asamland/NU-Smarticle/XBee3_Micro_Info/Image 2.jpeg

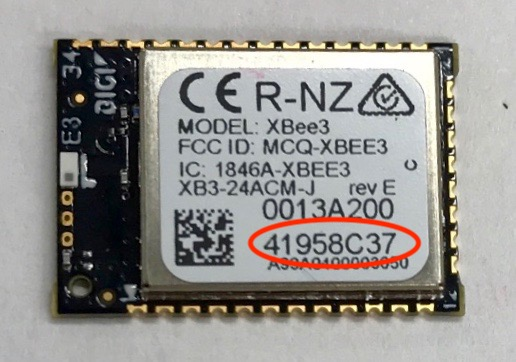
XBee3_Micro_Info/Image 2.jpeg
