asamland/NU-Smarticle/NU-Smarticle PCB Design/BOMs/Assemblyv2_BOM.xlsx

Item | Qty | Manufacturer | Mfg. Part No | Description
1 | 2 | Turnigy | 1440-A Servo (https://hobbyking.com/en_us/turnigytm-tgy-1440a-analog-servo-v2-0-8kg-0-10sec-4-4g.html) | Servos
2 | 1 | Molex | 51281-1294 (https://www.mouser.com/ProductDetail/Molex/51281-1294) | Connector b/w feather and top board
3 | 1 | eBoot | 1.25 mm JST 2 Pin Micro Female Connector (https://www.amazon.com/eBoot-Pairs-Electrical-Female-Connector/dp/B06WGM9W7S) | Battery connector
4 | 1 | Turnigy | nano-tech 200mAh 1S 35 (https://hobbyking.com/en_us/turnigy-nano-tech-200mah-1s-35-70c-lipoly-battery-5pcs.html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) | Battery
