asamland/NU-Smarticle/NU-Smarticle PCB Design/BOMs/Feather_BOM.xlsx

Item# | Ref Des | Qty | Manufacturer | Mfg Part no. | Package | Description/ Value | Type
1 | C8, C9, C11 | 3 |  |  | 0603 | 10nF | SMD
2 | C4, C6, C7, C10, C13 | 5 |  |  | 0603 | 0.1 uF | SMD
3 | C1,C14 | 2 |  |  | 0603 | 1.0uF | SMD
4 | C2,C3,C5,C12,C15 | 5 |  |  | 0603 | 10uF | SMD
5 | CON1 | 1 | Amphenol ICC | 10103594-0001LF |  | Micro B USB Connectors | SMD
6 | CON100 | 1 | Molex | 512811294 |  |  | SMD
7 | D1 | 1 |  |  | CHIP-LED 0603 | Red LED | SMD
8 | D2 | 1 | Diodes Inc. | SDM100K30L-7 | SOD-323 | Schottky Diode | SMD
9 | D3 | 1 |  |  | CHIP-LED 0603 | Orange LED | SMD
10 | Q1 | 1 | Didoes Inc. | DMG3418L | SOT23-R | P-Channel Mosfet | SMD
11 | R1, R2, R4, R6 | 4 |  |  | 0603 | 1K | SMD
12 | R3, R5, R10 | 3 |  |  | 0603 | 10k | SMD
13 | R7, R8, R9 | 3 |  |  | 0603 | 100k | SMD
14 | S1 | 1 | C&K | KMR231NG LFS |  | SMT Tact Switches | SMD
15 | S2 | 1 | C&K | PCM12SMTR |  | Single Pole, Double Throw (SPDT) Switch | SMD
16 | U1 | 1 | Microchip Technology | MCP73831T-2DCI/OT | SOT23-5 | MCP73831/2 LIPO Charger | SMD
17 | U2 | 1 | Diodes Inc. | AP2112K-3.3 | SOT23-5 | SOT23-5 Fixed Voltage Regulators | SMD
18 | U3 | 1 | Silicon Labs | CP2104 | QFN24_4MM_SMSC | CP2104 - USB to UART Bridge | SMD
19 | U4 | 1 | Microchip Technology | ATmega328PB-MUR | 32VFQFN | IC MCU 8BIT 32KB FLASH 32VFQFN | SMD
20 | U5 | 1 | Analog Devices | ADXL337BCPZ-RL | LFCSP_LQ-16 | ADXL337 Low Power 3-Axis ¬±3 g Accelerometer with Analog Output. | SMD
21 | Y1 | 1 | Murata | CSTNE8M00GH5C000R0 |  | 8mhz resonator | SMD
