asamland/NU-Smarticle/NU-Smarticle PCB Design/BOMs/TopBoardv2_BOM.xlsx

Item | Ref Des | Qty | Manufacturer | Mfg. Part No | Package | Description/Value | Type
1 | C1 | 1 |  |  | 0603 | 9.0pF | SMD
2 | C2 | 1 |  |  | 0603 | 1.0uF | SMD
3 | C3 | 1 |  |  | 0603 | 0.1uF | SMD
4 | CON100 | 1 | Molex | 51281-1294 |  |  | SMD
5 | PH1, PH2, PH3 | 3 | Advanced Photonics | PDV-P9007 |  |  | PTH
6 | R1, R2, R3 | 3 |  |  | 0603 | 10k | SMD
7 | R100 | 1 |  |  | 0603 | 0.1 | SMD
8 | S1 | 1 | C&K | PCM12SMTR |  | Single Pole, Double Throw (SPDT) Switch | SMD
9 | U1 | 1 | Digi | XB3-24ACM-J |  |  | SMD
10 | U100 | 1 | Texas Instruments | INA180B2 | SOT23-5 | Current Sense Op-Amp | SMD
