asamland/NU-Smarticle/NU-Smarticle PCB Design/BOMs/Inventory-v2.0.xlsx

Sheet: TopBoard
Part | Value | Device | Package | Description
C1 | 9.0pF | CAP_CERAMIC_0603MP | _0603MP | Ceramic Capacitors
C2 | 1.0uF | CAP_CERAMIC_0603MP | _0603MP | Ceramic Capacitors
C3 | 0.1uF | CAP_CERAMIC_0603MP | _0603MP | Ceramic Capacitors
CON100 | 12XFFCMOLEX_51281 | 12XFFCMOLEX_51281 | MOLEX_51281-1294
PH1 | A10 | A10 | PHOTORESISTOR | Sensor Robust Light Sensing Applications
PH2 | A10 | A10 | PHOTORESISTOR | Sensor Robust Light Sensing Applications
PH3 | A10 | A10 | PHOTORESISTOR | Sensor Robust Light Sensing Applications
R1 | 10k | RESISTOR_0603MP | _0603MP | Resistors
R2 | 10k | RESISTOR_0603MP | _0603MP | Resistors
R3 | 10k | RESISTOR_0603MP | _0603MP | Resistors
R100 | 0.1 | RESISTOR_0603MP | _0603MP | Resistors
S1 |  | SWITCH-SPDT-SMD-RIGHT-ANGLE | SWITCH_SPST_SMD_A | Single Pole, Double Throw (SPDT) Switch
U1 | XBEE3 | XBEE3 | XBEE3_MICRO | XBee 3 802.15
U100 | INA180B2 | INA180B2 | SOT23-5 | 50x gain current sense amplifier

Sheet: Feather
Part | Value | Device | Package | Description
C1 | 1uF | CAP_CERAMIC_0603MP | _0603MP | Ceramic Capacitors
C2 | 10µF | CAP_CERAMIC_0603MP | _0603MP | Ceramic Capacitors
C3 | 10µF | CAP_CERAMIC_0603MP | _0603MP | Ceramic Capacitors
C4 | 0.1uF | CAP_CERAMIC_0603MP | _0603MP | Ceramic Capacitors
C5 | 10uF | CAP_CERAMIC_0603MP | _0603MP | Ceramic Capacitors
C6 | 0.1uF | CAP_CERAMIC_0603MP | _0603MP | Ceramic Capacitors
C7 | 0.1uF | CAP_CERAMIC_0603MP | _0603MP | Ceramic Capacitors
C8 | 10nF | CAP_CERAMIC_0603MP | _0603MP | Ceramic Capacitors
C9 | 10nF | CAP_CERAMIC_0603MP | _0603MP | Ceramic Capacitors
C10 | 0.1uF | CAP_CERAMIC_0603MP | _0603MP | Ceramic Capacitors
C11 | 10nF | CAP_CERAMIC_0603MP | _0603MP | Ceramic Capacitors
C12 | 10uF | CAP_CERAMIC_0603MP | _0603MP | Ceramic Capacitors
C13 | 0.1uF | CAP_CERAMIC_0603MP | _0603MP | Ceramic Capacitors
C14 | 1uF | CAP_CERAMIC_0603MP | _0603MP | Ceramic Capacitors
C15 | 10uF | CAP_CERAMIC_0603MP | _0603MP | Ceramic Capacitors
R1 | 1K | RESISTOR_0603MP | _0603MP | Resistors
R2 | 1K | RESISTOR_0603MP | _0603MP | Resistors
R3 | 10K | RESISTOR_0603MP | _0603MP | Resistors
R4 | 1K | RESISTOR_0603MP | _0603MP | Resistors
R5 | 10K | RESISTOR_0603MP | _0603MP | Resistors
R6 | 1K | RESISTOR_0603MP | _0603MP | Resistors
R7 | 100k | RESISTOR_0603MP | _0603MP | Resistors
R8 | 100k | RESISTOR_0603MP | _0603MP | Resistors
R9 | 100k | RESISTOR_0603MP | _0603MP | Resistors
R10 | 10K | RESISTOR_0603MP | _0603MP | Resistors
CON100 | 12XFFCMOLEX_51281 | 12XFFCMOLEX_51281 | MOLEX_51281-1294
D1 | RED | LED0603_NOOUTLINE | CHIPLED_0603_NOOUTLINE | LED
D2 | MBR120 | DIODE-SCHOTTKYSOD-323 | SOD-323
D3 | ORANGE | LED0603_NOOUTLINE | CHIPLED_0603_NOOUTLINE | LED
IC1 | ATMEGA328P | MEGA8-MI | MLF32-TH | MICROCONTROLLER
Q1 | DMG341 | MOSFET-P | SOT23-R | P-Channel Mosfet
S1 |  | SWITCH-SPDT-SMD-RIGHT-ANGLE | SWITCH_SPST_SMD_A | Single Pole, Double Throw (SPDT) Switch
SW1 | KMR2 | SWITCH_TACT_SMT4.6X2.8 | BTN_KMR2_4.6X2.8 | SMT Tact Switches
U$1 | ADXL337 | ADXL337 | LFCSP_LQ-16 | ADXL337 Low Power 3-Axis ¬±3 g Accelerometer with Analog Output.
U1 | MCP73831T-2ACI/OT | MCP73831/2 | SOT23-5 | MCP73831/2 LIPO Charger
U2 | AP2112-3.3 | VREG_SOT23-5 | SOT23-5 | SOT23-5 Fixed Voltage Regulators
U3 | CP2104 | CP2104 | QFN24_4MM_SMSC | CP2104 - USB to UART Bridge
X1 | 20329 | USB_MICRO_20329_V2 | 4UCONN_20329_V2 | USB Connectors
Y1 | RESONATORMU | RESONATORMU | RESONATOR

Sheet: Summary
Component | qty | package | manufacturer | part number | board | notes
Capacitors | 18
10nF Cap | 3 | _0603 |  |  | Feather | accelerometer
0.1 uF Cap | 5 | _0603 |  |  | Feather
1.0uF Cap | 2 | _0603 |  |  | Feather
10uF Cap | 5 | _0603 |  |  | Feather
0.1 uF Cap | 1 | _0603 |  |  | Top
9pF Cap | 1 | _0603 |  |  | Top
1.0 uF Cap | 1 | _0603 |  |  | Top
Resistors | 14
1K Res | 4 | _0603 |  |  | Feather
10K Res | 3 | _0603 |  |  | Feather
100k Res | 3 | _0603 |  |  | Feather
10K Res | 3 | _0603 |  |  | Top
0.1 Res | 1 | _0603 |  |  | Top | current sense
Resonator | 1
8mhz resonator | 1 | SMD_wide | Murata | CSTNE8M00GH5C000R0 | Feather
Diodes | 3
Orange LED | 1 | _0603 |  |  | Feather
Red LED | 1 | _0603 |  |  | Feather
Schotky Diode | 1 | SOD-323 | Diodes, Inc. | SDM100K30L-7 | Feather
ICs | 6
ATMEGA 328PB | 1 | 32VQFN | Microchip Technology | ATmega328PB-MUR | Feather
Lipo Charger | 1 | SOT23-5 | Microchip Technology | MCP73831T-2DCI/OT | Feather
500mA 3.3V regulator | 1 | SOT23-5 | Diodes Inc. | AP2112K-3.3 | Feather
3-axis accelerometer | 1 | LFCSP_LQ-16 | Analog Devices | ADXL337BCPZ-RL | Feather
Serial Chip | 1 | QFN24_4MM_SMSC | Silicon Labs | CP2104 | Feather
Xbee3 Micro | 1 | Micro | Digi International | XB3-24ACM-J | Top
Current Sense Amp | 1 | SOT23-5 | Texas Instruments | INA180B2 | Top
Transistors | 1
P-channel Mosfet | 1 | SOT23-5 | Didoes Inc. | DMG3418L | Feather
Switches | 2
Slide Switch | 1 | - | C&K | PCM12SMTR | Feather
Slide Switch | 1 | - | C&K | PCM12SMTR | Top
Button Switch | 1 | BTN_KMR2_4.6X2.8 | C&K | KMR231NG LFS | Feather
Connectors | 4
Micro USB port | 1 | 4UCONN_20329_V2 | unknown | 98-MB05PMXX-01 | Feather
12pin FFC | 1 | - | Molex | Molex 15166-0117 | Feather/Top
12pin FFC connector | 2 |  | Molex | 512811294 | Feather and Top
External Components
PhotoResistor | 3 | PTH |  | PDV-P9007-ND | Top
Servo | 2 |  |  | TGY-1440A | N/A
Li-Po 1S | 1 |  |  | Turnigy 150mAh 0.15C

Sheet: Current Inventory
Component | package | Digi-Key Part number (or vendor) | part number | updated qty | Purchased | Manual Adjustments | Feathers Made | TopBoards Made | Assemblies Made | qty as of 1/23/20
 |  |  |  |  |  |  | 0 | 0 | 0
Capacitors
9pF Cap | _0603 |  |  | 87 | 0 | 0 | 0 | 1 | 0 | 87
10nF Cap | _0603 |  |  | 88 | 0 | 0 | 3 | 0 | 0 | 88
0.1 uF Cap | _0603 |  |  | 917 | 0 | 0 | 5 | 1 | 0 | 917
1.0uF Cap | _0603 |  |  | 449 | 0 | 0 | 2 | 1 | 0 | 449
10uF Cap | _0603 |  |  | 430 | 0 | 0 | 5 | 0 | 0 | 430
Resistors
0.1 Res | _0603 |  |  | 104 | 0 | 0 |  | 1 | 0 | 104
1K Res | _0603 |  |  | 924 | 0 | 0 | 4 | 0 | 0 | 924
10K Res | _0603 |  |  | 909 | 0 | 0 | 3 | 3 | 0 | 909
100k Res | _0603 |  |  | 948 | 0 | 0 | 3 | 0 | 0 | 948
Resonator
8mhz resonator | SMD_wide |  | CSTNE8M00GH5C000R0 | 2 | 0 | 0 | 1 | 0 | 0 | 2
Diodes
Orange LED | _0603 |  |  | 0 | 0 | 0 | 1 | 0 | 0 | 0
Yellow LED | _0603 |  |  | 25 | 0 | 0 | 0 | 0 | 0 | 25
Red LED | _0603 |  |  | 0 | 0 | 0 | 1 | 0 | 0 | 0
Schotky Diode | SOD-323 |  | SDM100K30L-7‎ | 2 | 0 | 0 | 1 | 0 | 0 | 2
ICs
ATMEGA 328PB | MLF-32TH |  |  | 1 | 0 | 0 | 1 | 0 | 0 | 1
Lipo Charger | SOT23-5 |  | MCP73831T-2ACI/OT | 1 | 0 | 0 | 1 | 0 | 0 | 1
500mA 3.3V regulator | SOT23-5 |  | AP2112-3.3 | 1 | 0 | 0 | 1 | 0 | 0 | 1
3-axis accelerometer | LFCSP_LQ-16 |  | ADXL337 | 3 | 0 | 0 | 0 | 0 | 0 | 3
Serial Chip | QFN24_4MM_SMSC |  | CP2102N | 6 | 0 | 0 | 1 | 0 | 0 | 6
Xbee3 Micro | Micro |  | XB3-24ACM-J | 6 | 0 | 0 | 0 | 1 | 0 | 6
Current Sense Amp | SOT23-5 |  | INA180B2 | 8 | 0 | 0 | 0 | 1 | 0 | 8
Transistors
P-channel Mosfet | SOT23-5 |  | DMG341 | 5 | 0 | 0 | 1 | 0 | 0 | 5
Switches
Slide Switch | - |  | Sparkfun COM-10860 | 7 | 0 | 0 | 1 | 1 | 0 | 7
Button Switch | BTN_KMR2_4.6X2.8 |  | BTN_KMR2_4.6X2.8 | 10 | 0 | 0 | 1 | 0 | 0 | 10
Connectors
Micro USB port | 4UCONN_20329_V2 |  | Adafruit micro USB | 7 | 0 | 0 | 1 | 0 | 0 | 7
12pin FFC | - |  | Molex 15166-0117 | 9 | 0 | 0 | 0 | 1 | 0 | 9
12pin FFC connector |  |  | MOLEX_51281-1294 | 6 | 0 | 0 | 1 | 1 | 0 | 6
Battery Connector |  |  |  | 1 | 0 | 0 | 0 | 0 | 1 | 1
External Components
PhotoResistor | PTH |  |  | 6 | 0 | 0 | 0 | 3 | 0 | 6
Servo |  | HobbyKing | TGY-1440A | 9 | 0 | 4 | 0 | 0 | 2 | 13
Li-Po 1S |  | HobbyKing | Turnigy 150mAh 0.15C | 6 | 0 | 2 | 0 | 0 | 1 | 8
PCBs
Feather-board |  |  |  | 3 | 0 | 0 | 1 | 0 | 0 | 3
top board |  |  |  | 3 | 0 | 0 | 0 | 1 | 0 | 3
Old Parts
300 Ohm Resistor | _0603 |  |  | 100
4.7 uF Cap | _0603 |  |  | 90
100pF Cap | _0603 |  |  | 90
Mems Mic |  |  | ADMP401 | 10
Op Amp | SOT23-5 |  | OPA344 | 10
Last updated: | 2020-01-23
