asamland/NU-Smarticle/Solidworks/NU-Smarticle Design/battery/Battery - Assembly.SLDASM

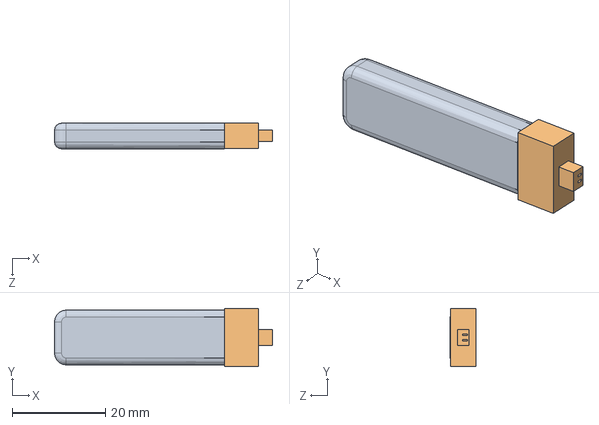
[picture p2: CAD file, 2020-02-05]
Solidworks/NU-Smarticle Design/battery/Battery - Assembly.SLDASM
46.8 x 12.5 x 5.50 mm
Battery - Body
Battery - Connector
