asamland/NU-Smarticle/Solidworks/NU-Smarticle Design/servo/Servo - Assembly.SLDASM

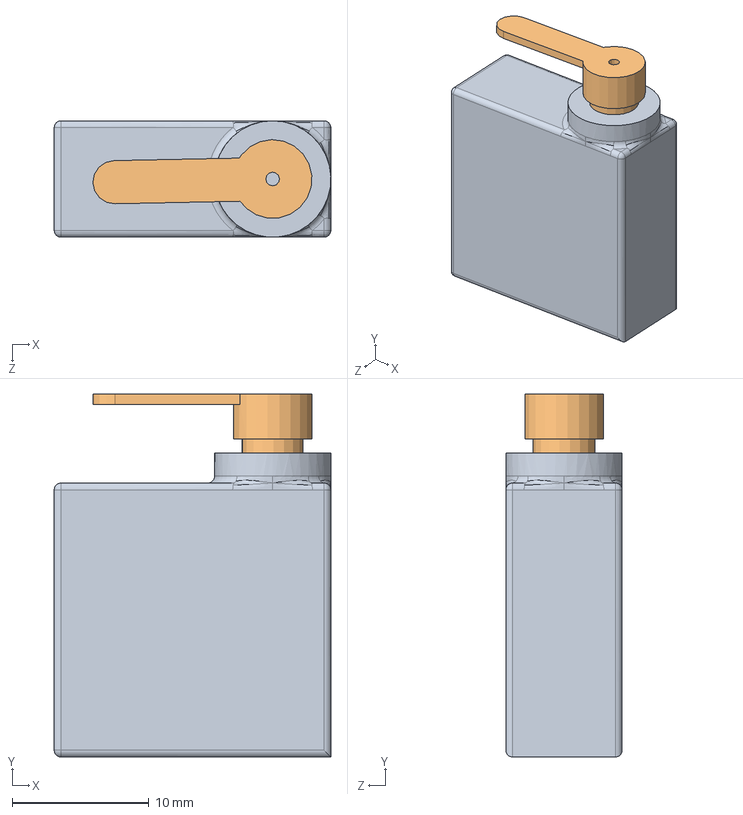
[picture p3: CAD file, 2020-02-05]
Solidworks/NU-Smarticle Design/servo/Servo - Assembly.SLDASM
20.2 x 26.5 x 8.50 mm
Servo - Body
Servo - Horn
