asamland/NU-Smarticle/Solidworks/NU-Smarticle Design/Smarticle_Assembly.SLDASM

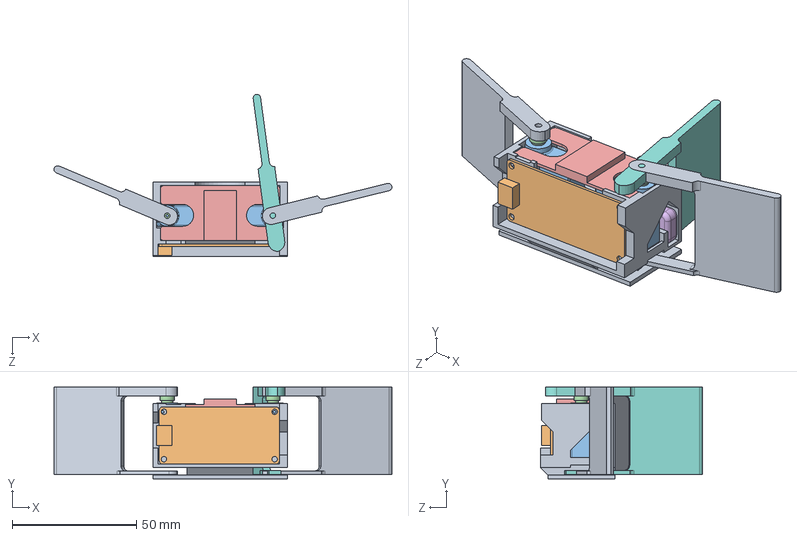
[picture p4: CAD file, 2020-02-17]
Solidworks/NU-Smarticle Design/Smarticle_Assembly.SLDASM
135.8 x 36.9 x 65.2 mm
Feather
Servo - Body x 2
Servo - Horn x 2
Battery - Body
Battery - Connector
TopBoard
Arm2 x 2
