asamland/NU-Smarticle/Solidworks/Simulation parts/simulation_assembly.SLDASM

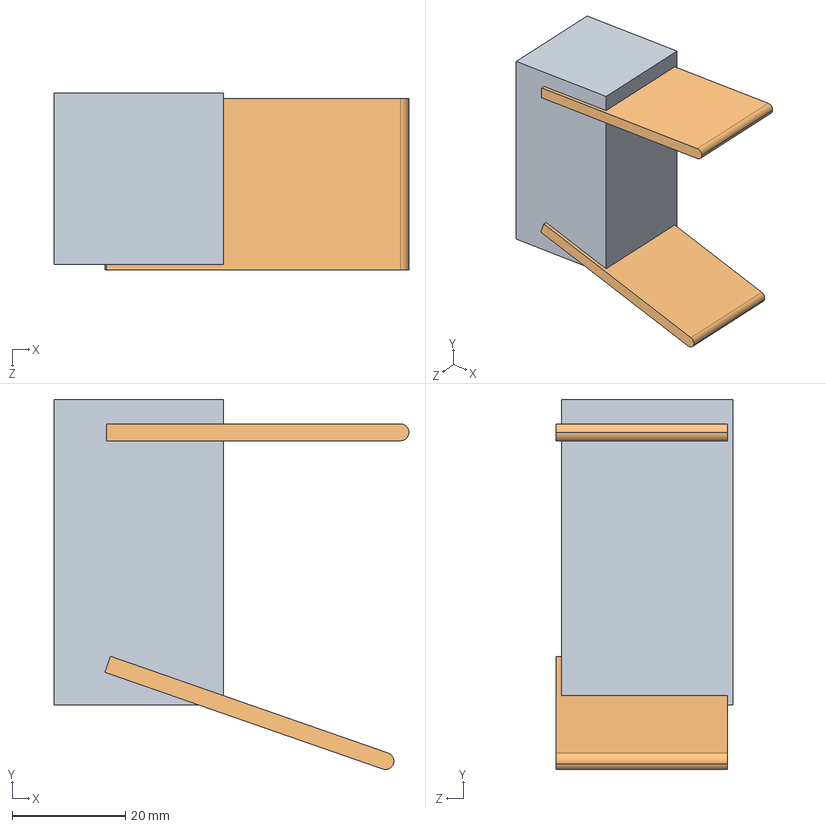
[picture p5: CAD file, 2020-03-06]
Solidworks/Simulation parts/simulation_assembly.SLDASM
62.8 x 65.4 x 31.3 mm
simulation_body
simulation_arm x 2
