asamland/NU-Smarticle/Solidworks/NU-Smarticle Design/vibration motor/vibration motor - assembly.SLDASM

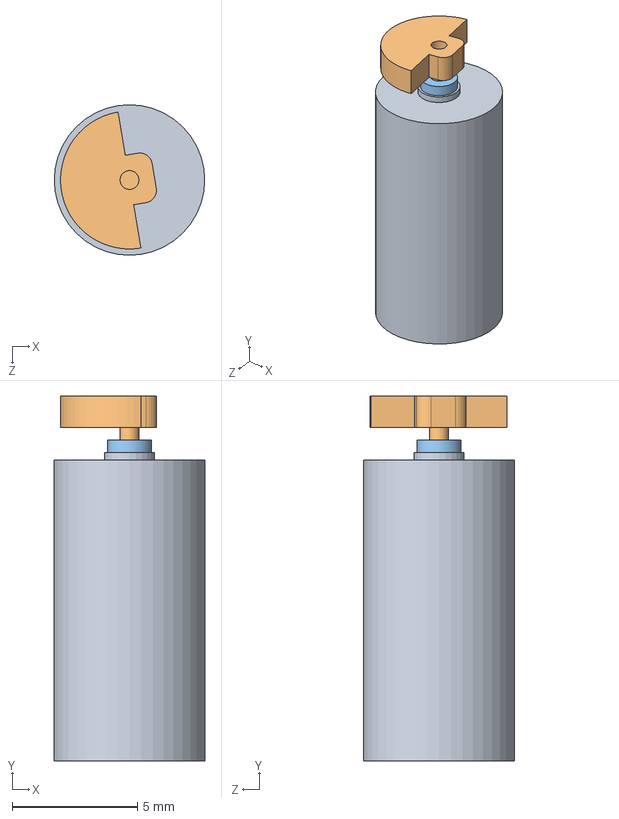
[picture p6: CAD file, 2019-07-31]
Solidworks/NU-Smarticle Design/vibration motor/vibration motor - assembly.SLDASM
6.00 x 14.6 x 6.00 mm
vibration motor - body
vibration motor - spinner
vibration motor - washer
