asamland/NU-Smarticle/Regular State Machine Solidworks/slide.SLDPRT

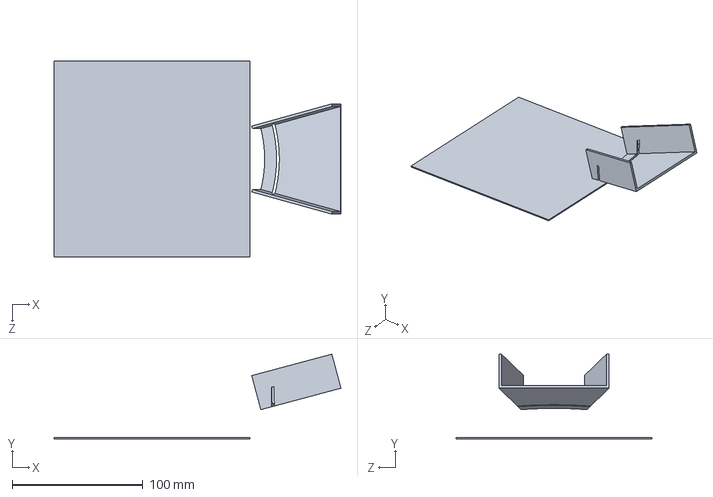
[picture p7: CAD file, 2020-01-08]
Regular State Machine Solidworks/slide.SLDPRT
219.9 x 64.9 x 150.0 mm
