asamland/NU-Smarticle/Smarticle Herding/Sawyer_lightHolder.SLDPRT

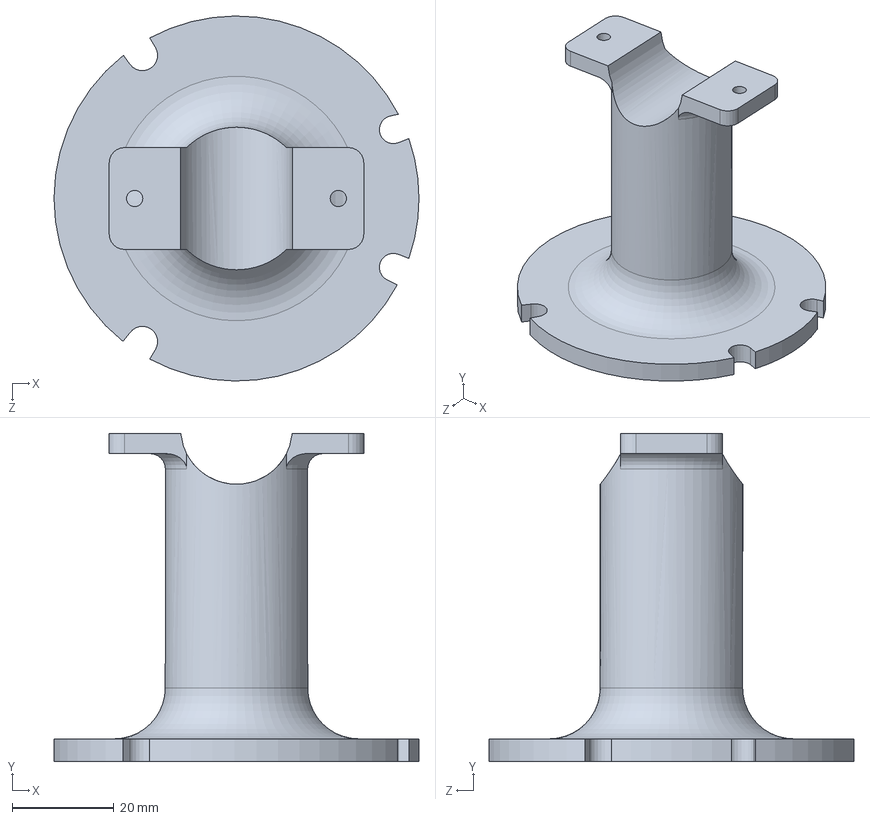
[picture p8: CAD file, 2020-03-09]
Smarticle Herding/Sawyer_lightHolder.SLDPRT
71.7 x 64.5 x 71.7 mm
