asamland/NU-Smarticle/Solidworks/NU-Smarticle Design/Arm.SLDPRT

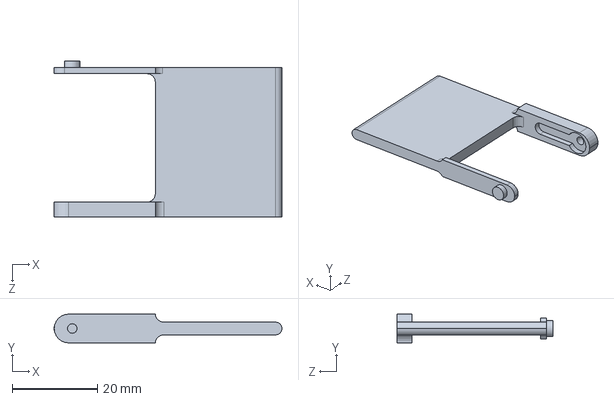
[picture p9: CAD file, 2020-03-06]
Solidworks/NU-Smarticle Design/Arm.SLDPRT
53.5 x 6.75 x 36.7 mm
