asamland/NU-Smarticle/Solidworks/NU-Smarticle Design/battery/Battery - Body.SLDPRT

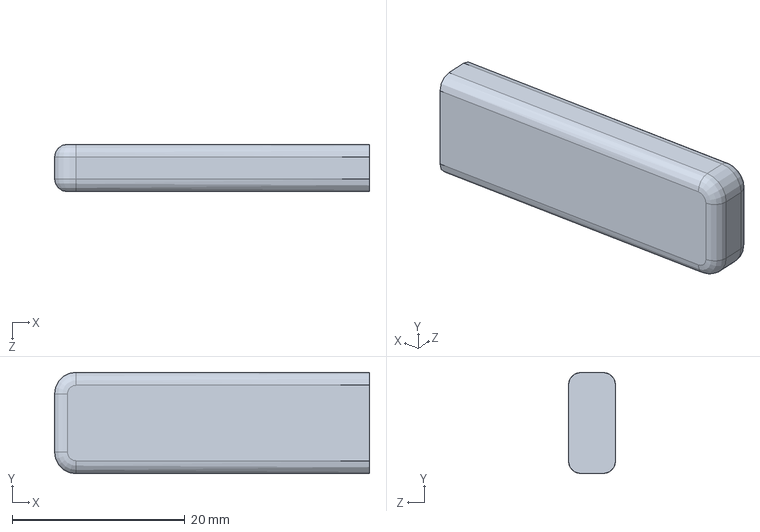
[picture p10: CAD file, 2020-02-05]
Solidworks/NU-Smarticle Design/battery/Battery - Body.SLDPRT
36.5 x 11.8 x 5.50 mm
