asamland/NU-Smarticle/Solidworks/NU-Smarticle Design/servo/Servo - Horn.SLDPRT

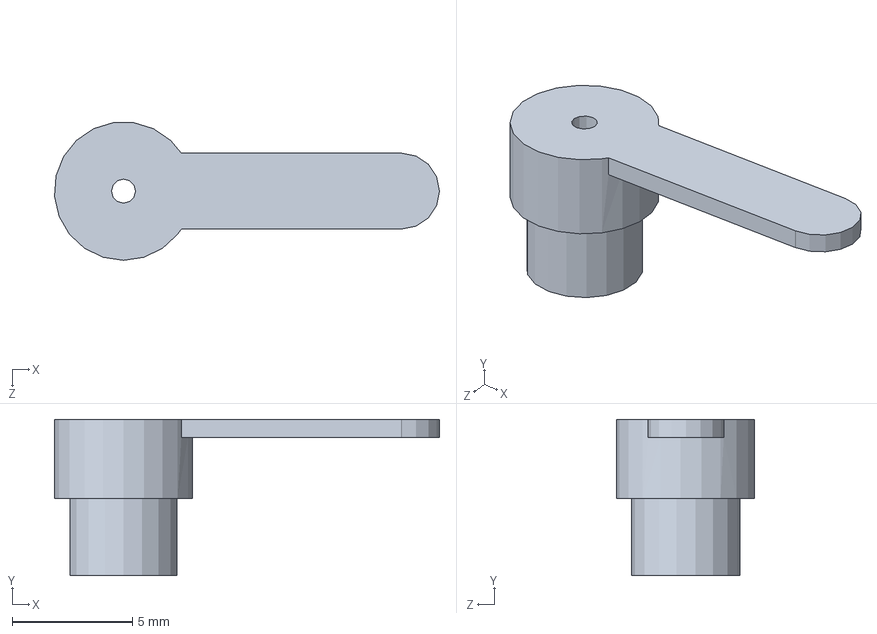
[picture p11: CAD file, 2020-02-05]
Solidworks/NU-Smarticle Design/servo/Servo - Horn.SLDPRT
16.0 x 6.50 x 5.72 mm
