asamland/NU-Smarticle/Solidworks/NU-Smarticle Design/vibration motor/vibration motor - body.SLDPRT

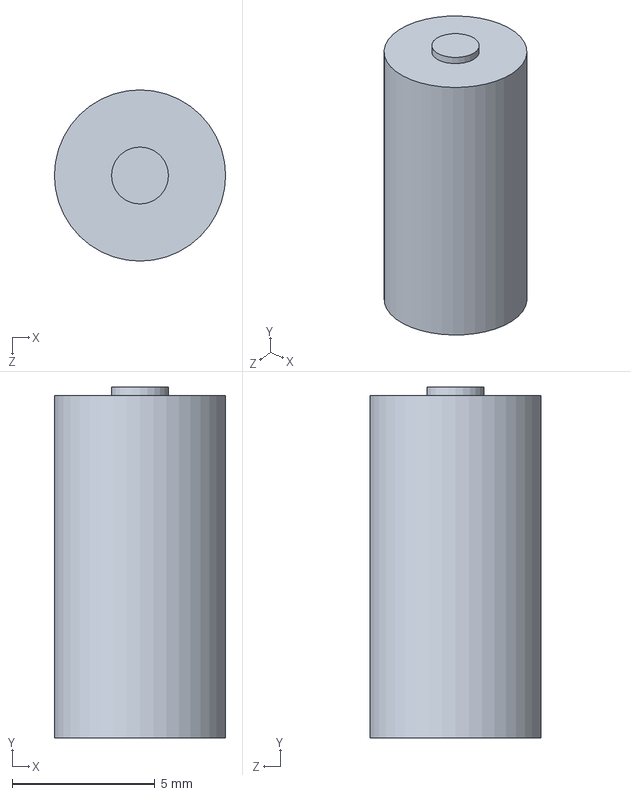
[picture p12: CAD file, 2019-07-31]
Solidworks/NU-Smarticle Design/vibration motor/vibration motor - body.SLDPRT
6.00 x 12.3 x 6.00 mm
