asamland/NU-Smarticle/Solidworks/Simulation parts/simulation_arm.SLDPRT

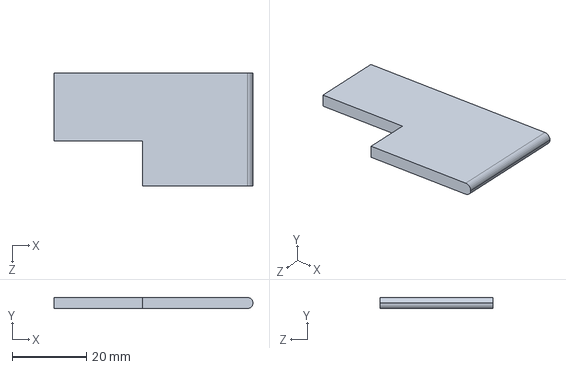
[picture p13: CAD file, 2020-03-06]
Solidworks/Simulation parts/simulation_arm.SLDPRT
53.5 x 3.00 x 30.3 mm
