asamland/NU-Smarticle/Solidworks/Spill_Ring_small_no_crown.SLDPRT

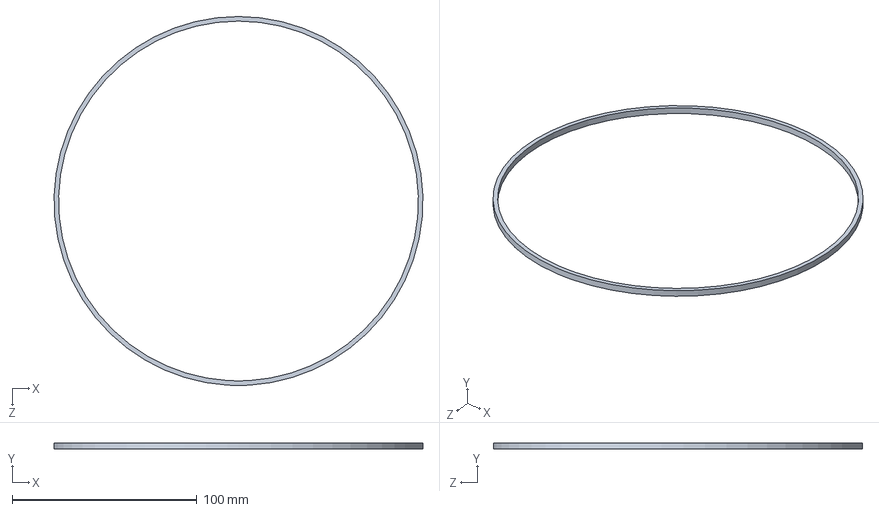
[picture p14: CAD file, 2019-12-10]
Solidworks/Spill_Ring_small_no_crown.SLDPRT
199.9 x 3.50 x 200.0 mm
