asamland/NU-Smarticle/Solidworks/stl Files/Case_3.STL

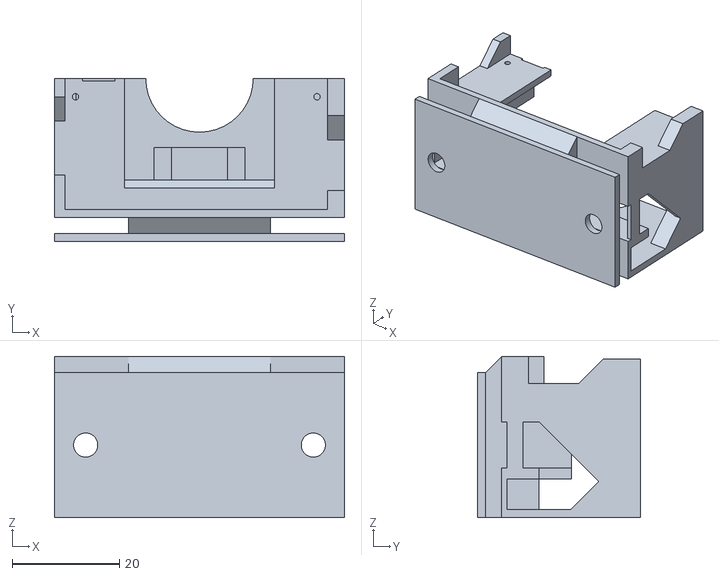
[picture p15: CAD file, 2019-11-21]
Solidworks/stl Files/Case_3.STL
54.0 x 30.4 x 30.0
