asamland/NU-Smarticle/Regular State Machine Solidworks/Flag_ring_w_lip.SLDPRT

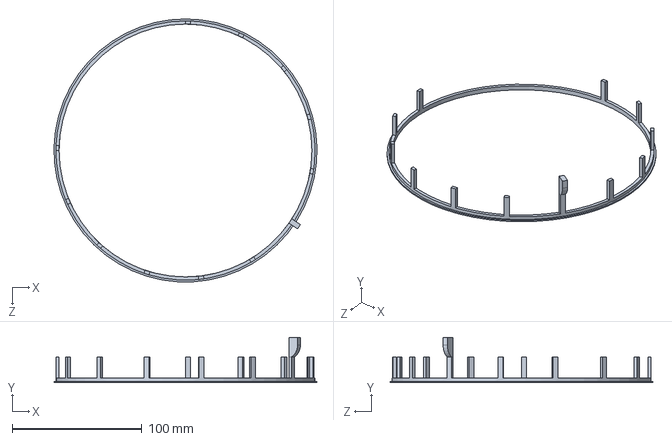
[picture p16: CAD file, 2020-01-08]
Regular State Machine Solidworks/Flag_ring_w_lip.SLDPRT
202.9 x 35.0 x 203.0 mm
