asamland/NU-Smarticle/Smarticle Herding/clamping_part.SLDPRT

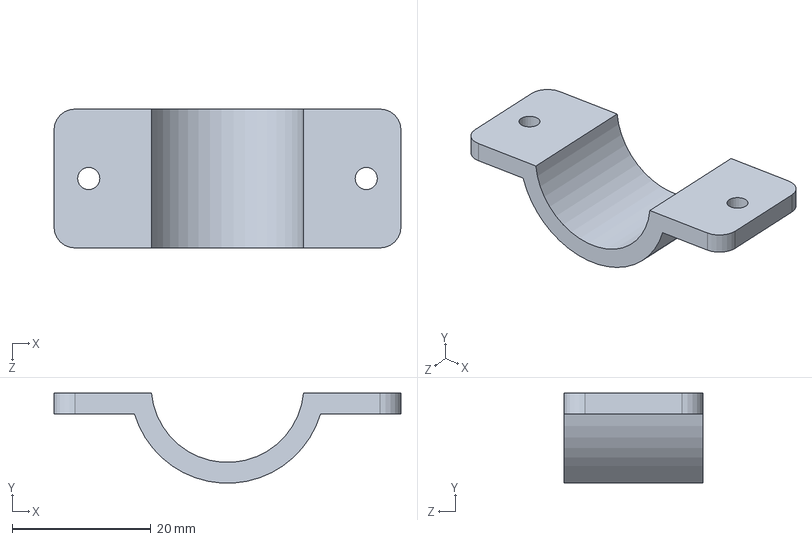
[picture p17: CAD file, 2020-03-09]
Smarticle Herding/clamping_part.SLDPRT
50.0 x 13.0 x 20.0 mm
