asamland/NU-Smarticle/Solidworks/Spill_Ring.SLDPRT

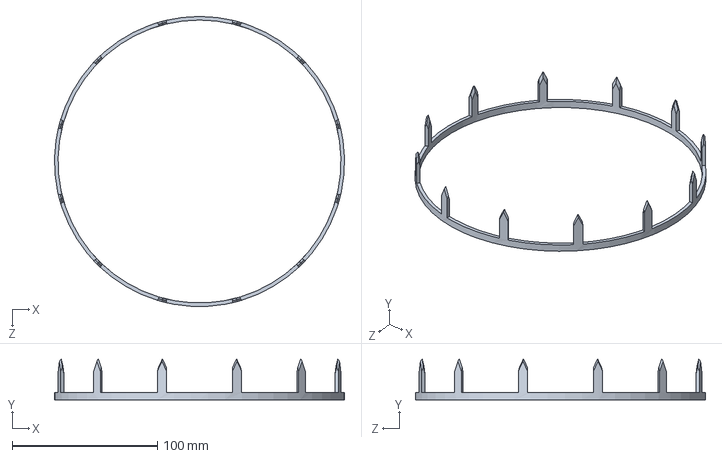
[picture p18: CAD file, 2019-10-24]
Solidworks/Spill_Ring.SLDPRT
199.9 x 28.0 x 200.0 mm
