asamland/NU-Smarticle/Regular State Machine Solidworks/gate.SLDPRT

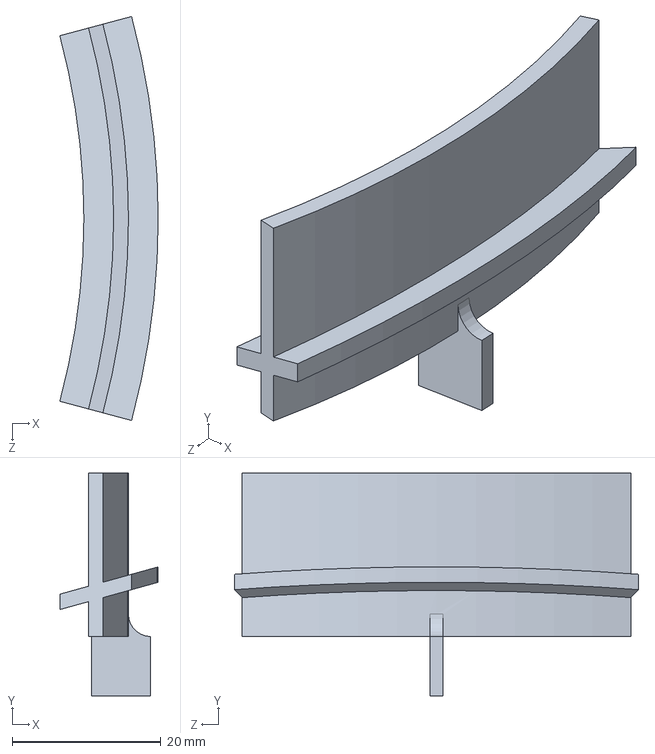
[picture p19: CAD file, 2020-01-08]
Regular State Machine Solidworks/gate.SLDPRT
13.2 x 30.0 x 54.4 mm
