asamland/NU-Smarticle/Smarticle Herding/Sawyer_Adapter_Tool_Plate_customer_use_(Rethink_Grippers).sldprt

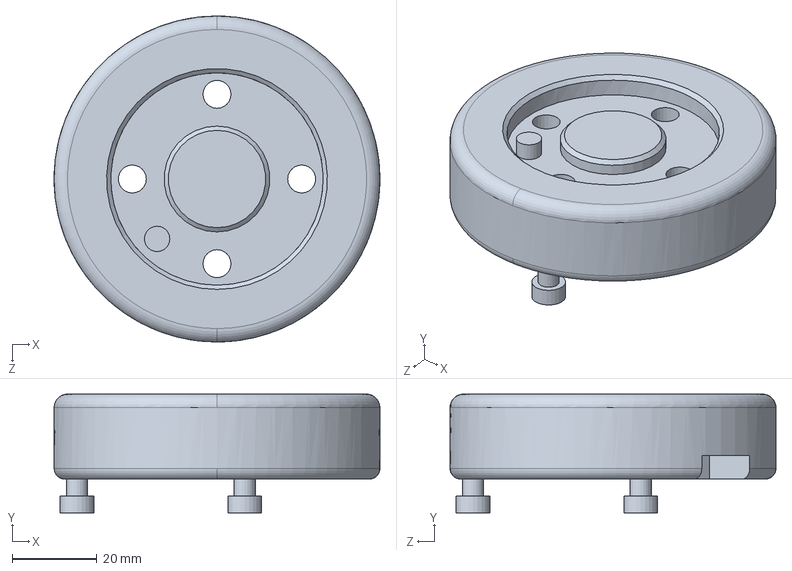
[picture p20: CAD file, 2020-03-09]
Smarticle Herding/Sawyer_Adapter_Tool_Plate_customer_use_(Rethink_Grippers).sldprt
77.0 x 28.1 x 77.0 mm
