asamland/NU-Smarticle/Solidworks/NU-ring.SLDPRT

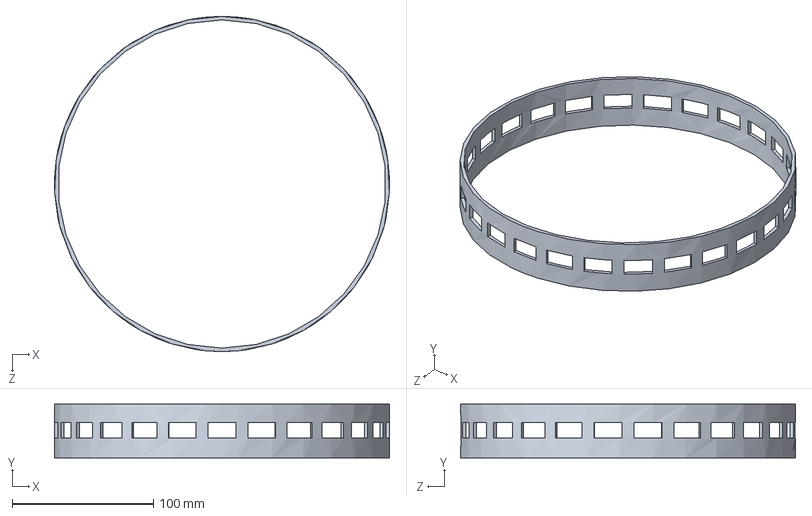
[picture p21: CAD file, 2019-07-31]
Solidworks/NU-ring.SLDPRT
236.8 x 38.0 x 237.0 mm
