asamland/NU-Smarticle/Solidworks/NU-Smarticle Design/battery/Battery - Connector.SLDPRT

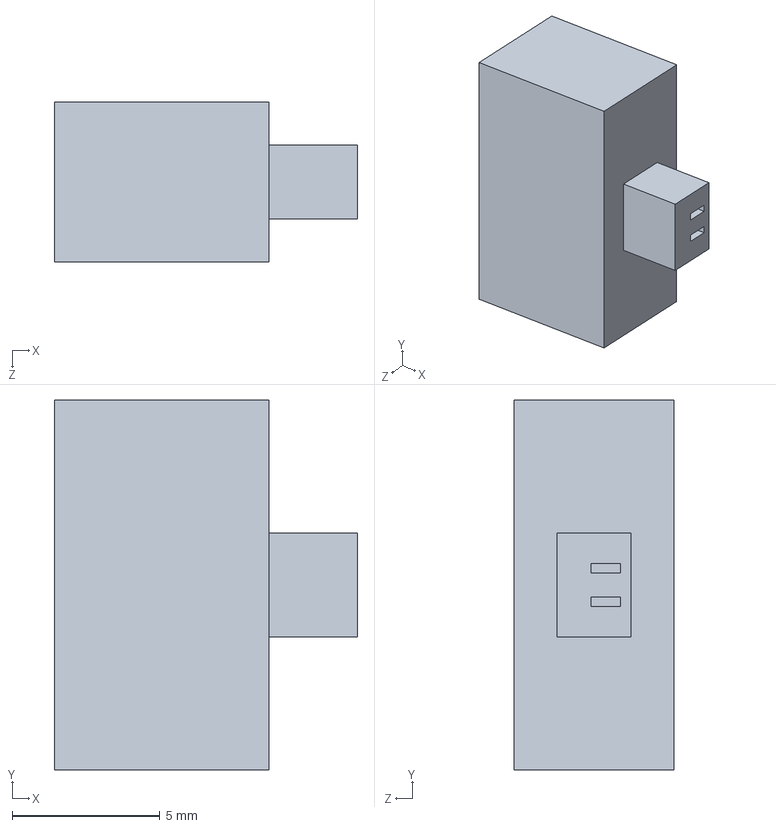
[picture p22: CAD file, 2020-02-05]
Solidworks/NU-Smarticle Design/battery/Battery - Connector.SLDPRT
10.2 x 12.5 x 5.40 mm
