asamland/NU-Smarticle/Solidworks/NU-Smarticle Design/servo/Servo - Solar Arm.SLDPRT

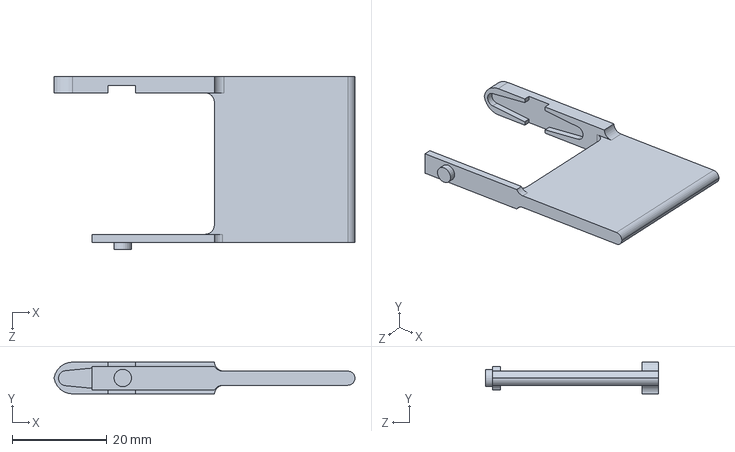
[picture p23: CAD file, 2020-02-05]
Solidworks/NU-Smarticle Design/servo/Servo - Solar Arm.SLDPRT
63.7 x 6.75 x 36.7 mm
