asamland/NU-Smarticle/Solidworks/NU-Smarticle Design/vibration motor/vibration motor - spinner.SLDPRT

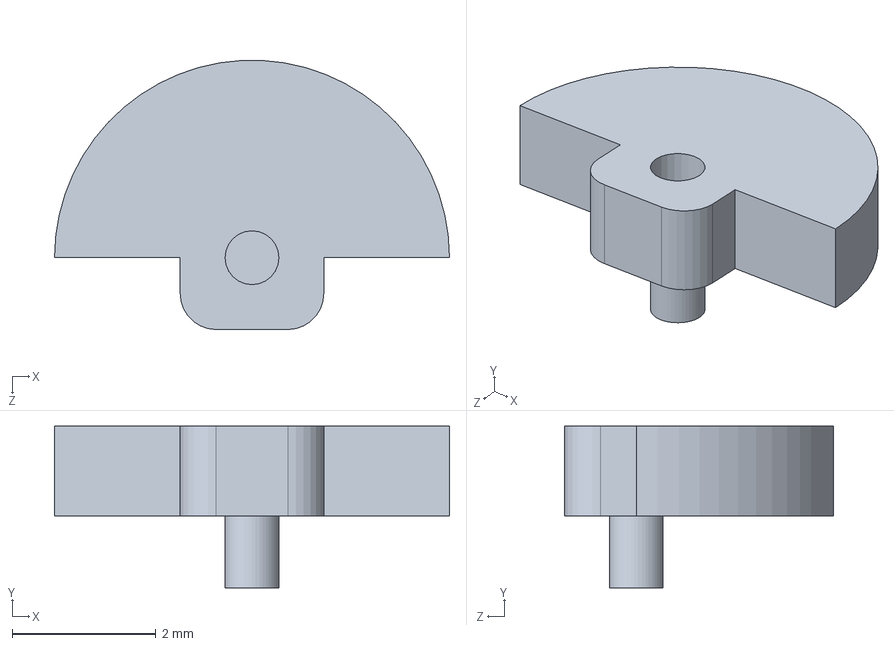
[picture p24: CAD file, 2019-07-31]
Solidworks/NU-Smarticle Design/vibration motor/vibration motor - spinner.SLDPRT
5.50 x 2.25 x 3.75 mm
