asamland/NU-Smarticle/Solidworks/Simulation parts/200mm_ring_solid.SLDPRT

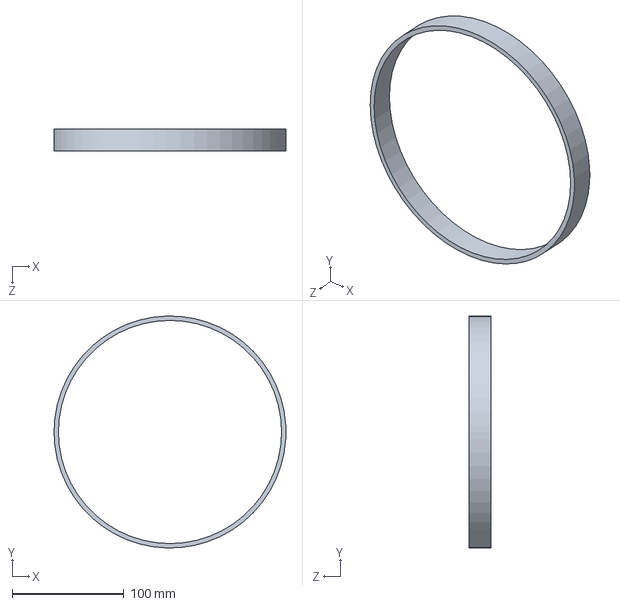
[picture p25: CAD file, 2020-03-06]
Solidworks/Simulation parts/200mm_ring_solid.SLDPRT
208.0 x 207.9 x 20.0 mm
