asamland/NU-Smarticle/Smarticle Herding/200mm_ring_thirds.SLDPRT

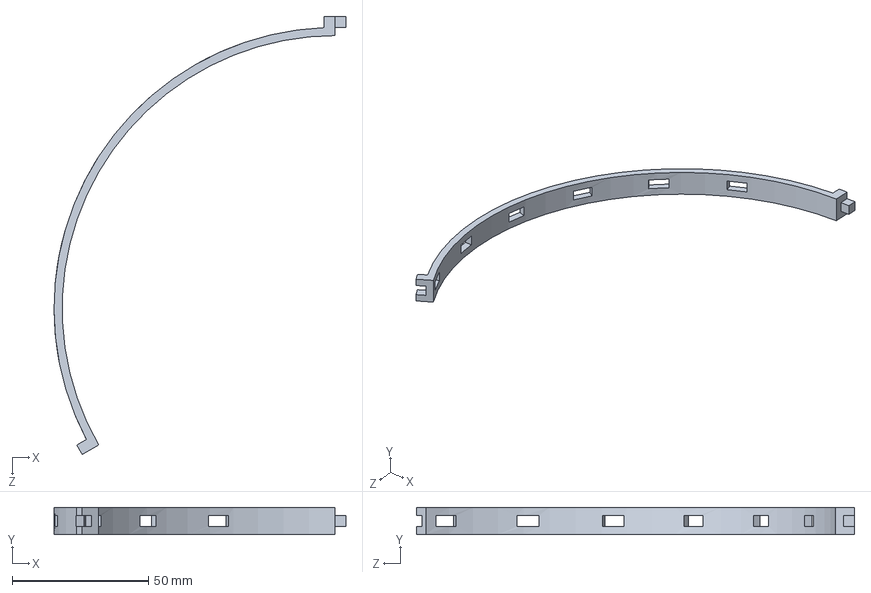
[picture p26: CAD file, 2020-01-24]
Smarticle Herding/200mm_ring_thirds.SLDPRT
107.0 x 10.0 x 160.5 mm
