asamland/NU-Smarticle/Solidworks/NU-Smarticle Design/Feather.SLDPRT

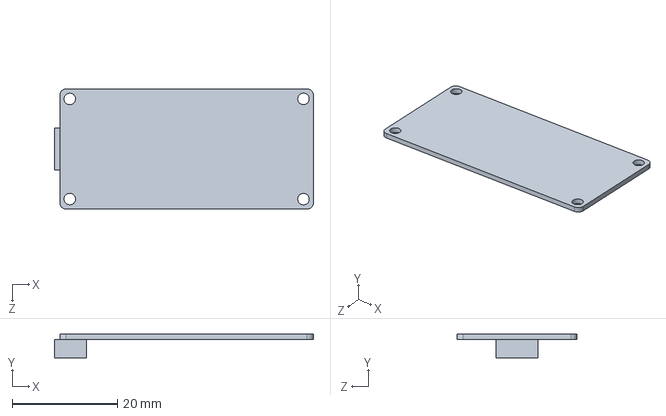
[picture p27: CAD file, 2020-02-05]
Solidworks/NU-Smarticle Design/Feather.SLDPRT
49.3 x 4.50 x 22.9 mm
