asamland/NU-Smarticle/Solidworks/NU-Smarticle Design/servo/Servo - Body.SLDPRT

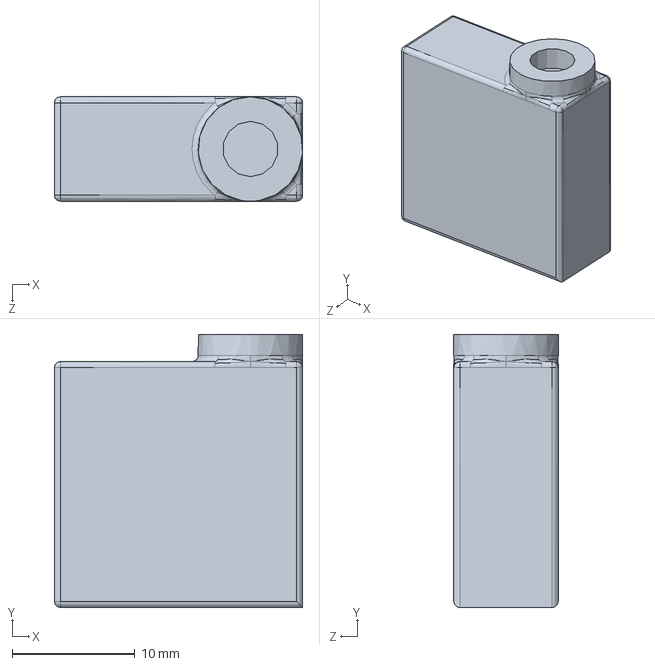
[picture p28: CAD file, 2020-02-05]
Solidworks/NU-Smarticle Design/servo/Servo - Body.SLDPRT
20.2 x 22.2 x 8.50 mm
