asamland/NU-Smarticle/Solidworks/Simulation parts/simulation_body.SLDPRT

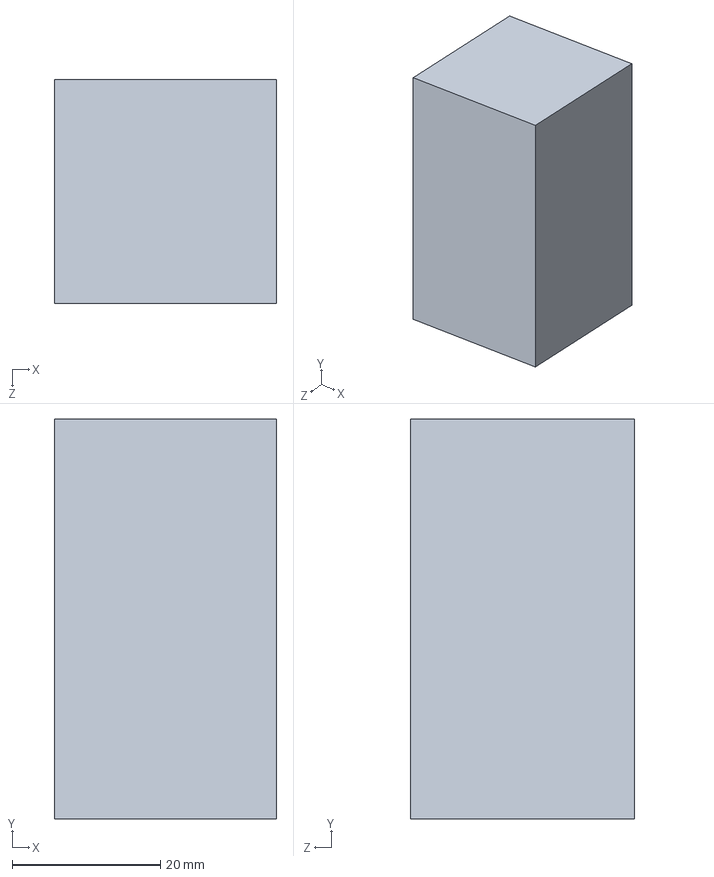
[picture p29: CAD file, 2020-02-17]
Solidworks/Simulation parts/simulation_body.SLDPRT
30.0 x 54.0 x 30.3 mm
