asamland/NU-Smarticle/Smarticle Herding/192mm_ring.SLDPRT

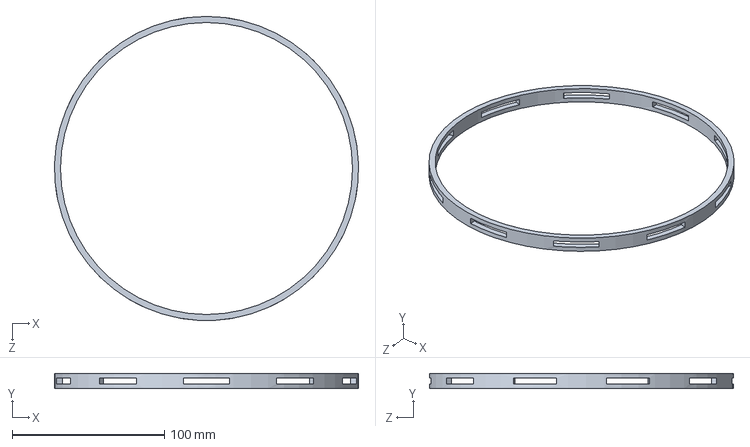
[picture p30: CAD file, 2020-01-23]
Smarticle Herding/192mm_ring.SLDPRT
199.9 x 10.0 x 200.0 mm
