asamland/NU-Smarticle/Solidworks/NU-Smarticle Design/TopBoard.SLDPRT

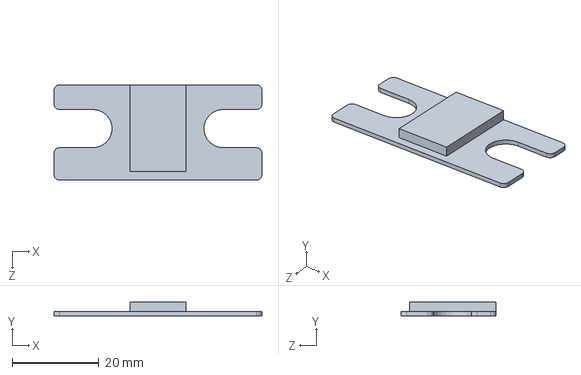
[picture p31: CAD file, 2020-02-05]
Solidworks/NU-Smarticle Design/TopBoard.SLDPRT
48.0 x 3.25 x 22.0 mm
