asamland/NU-Smarticle/Smarticle Herding/211mm_ring_thirds.SLDPRT

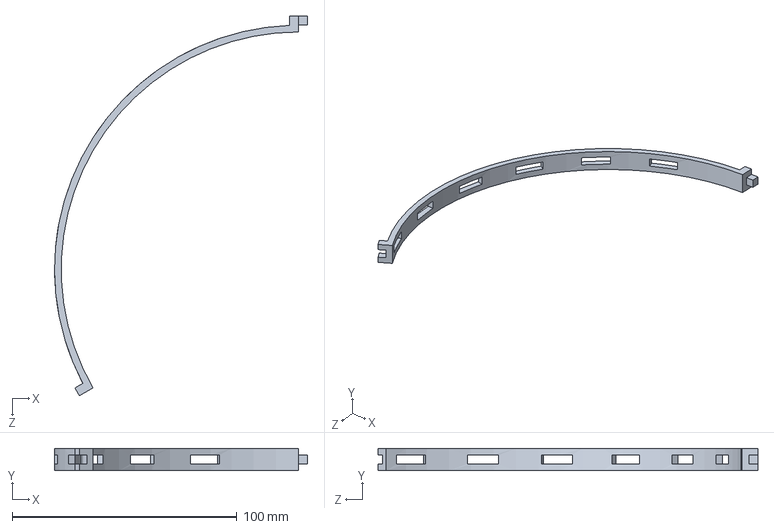
[picture p32: CAD file, 2020-01-23]
Smarticle Herding/211mm_ring_thirds.SLDPRT
112.5 x 10.0 x 168.8 mm
