asamland/NU-Smarticle/Solidworks/NU-Smarticle Design/Photoresistor.SLDPRT

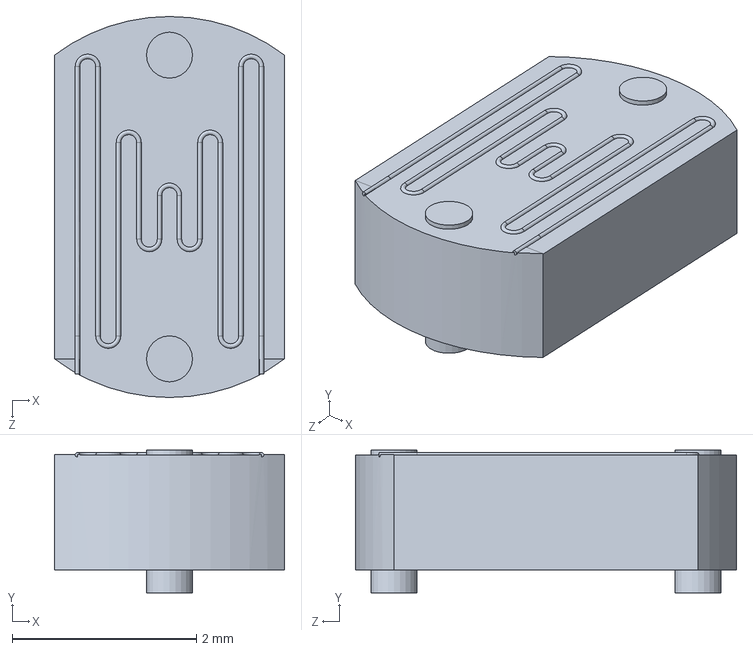
[picture p33: CAD file, 2019-07-31]
Solidworks/NU-Smarticle Design/Photoresistor.SLDPRT
2.50 x 1.55 x 4.14 mm
