asamland/NU-Smarticle/Smarticle Herding/230mm_ring_thirds.SLDPRT

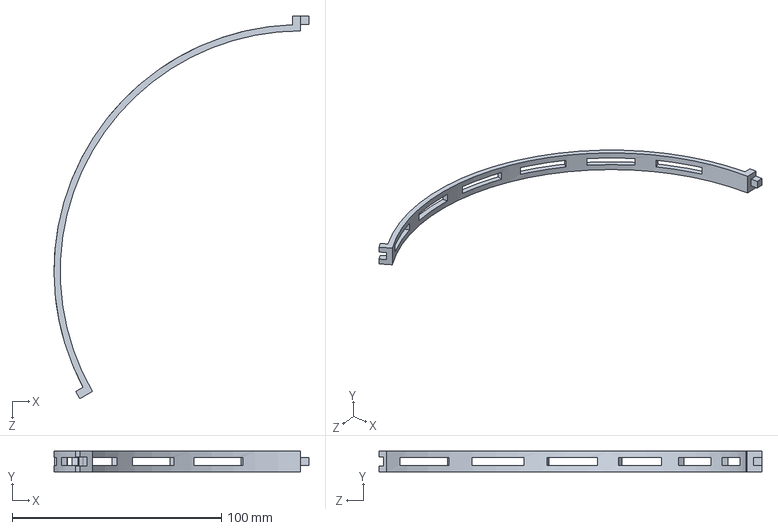
[picture p34: CAD file, 2020-01-23]
Smarticle Herding/230mm_ring_thirds.SLDPRT
122.0 x 10.0 x 183.0 mm
