asamland/NU-Smarticle/Solidworks/NU-Smarticle Design/B2B-PH-K-S.STEP

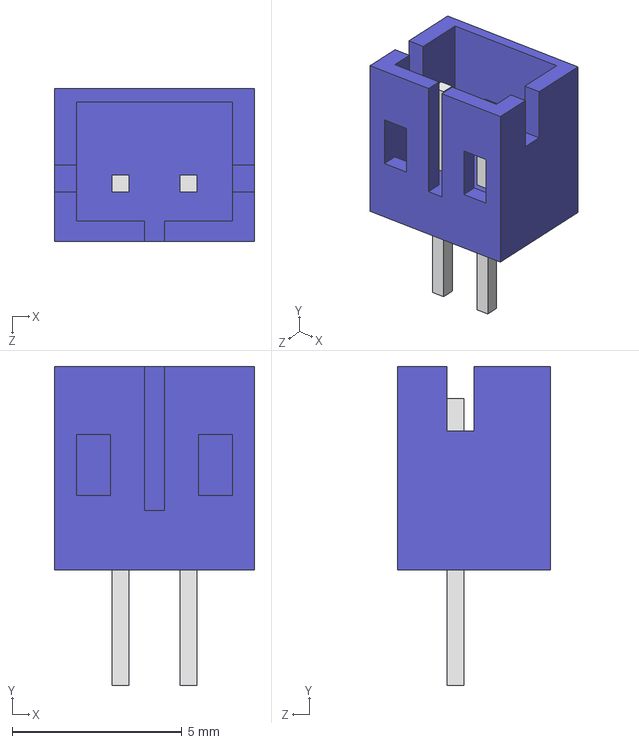
[picture p35: CAD file, 2019-07-31]
Solidworks/NU-Smarticle Design/B2B-PH-K-S.STEP
5.90 x 9.40 x 4.50 mm
