asamland/NU-Smarticle/Smarticle Herding/220mm_ring.SLDPRT

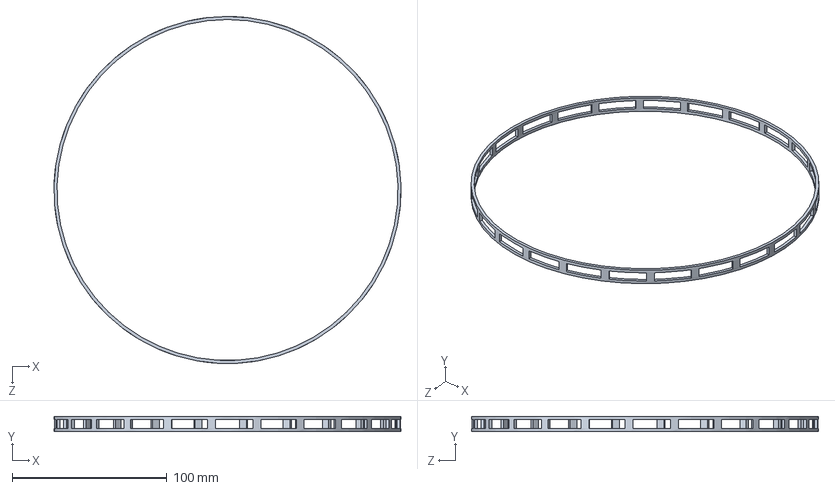
[picture p36: CAD file, 2020-01-16]
Smarticle Herding/220mm_ring.SLDPRT
223.9 x 10.0 x 224.0 mm
