asamland/NU-Smarticle/Smarticle Herding/230mm_ring.SLDPRT

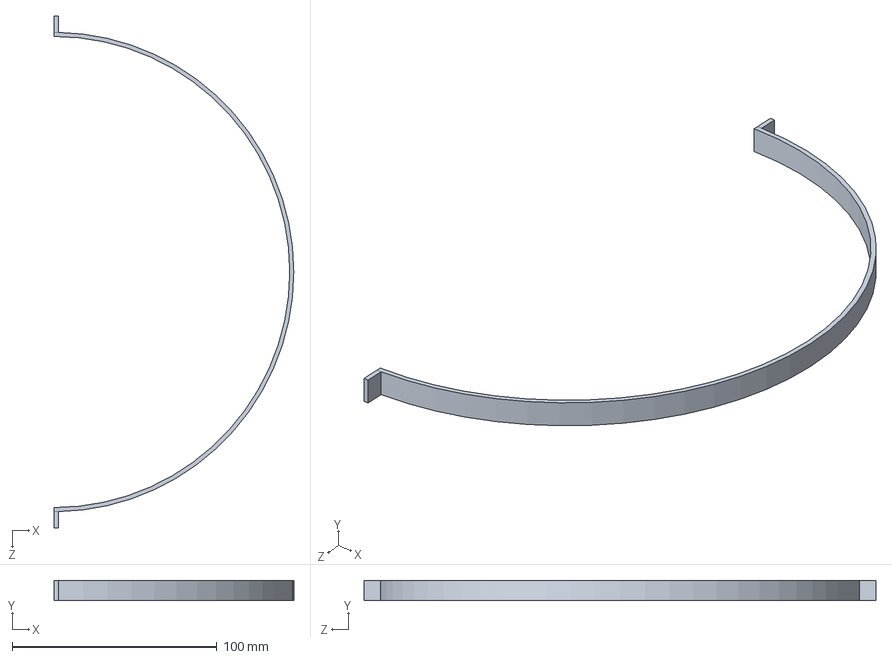
[picture p37: CAD file, 2020-01-16]
Smarticle Herding/230mm_ring.SLDPRT
117.0 x 10.0 x 250.0 mm
