asamland/NU-Smarticle/(list of files, cad)

Other CAD files:
Solidworks/stl Files/Half_Arm.STL
Solidworks/NU-Smarticle Design/Body.SLDPRT
Solidworks/stl Files/spiked_ring.STL
Smarticle Herding/192mm_ring.STL
Smarticle Herding/200mm_ring_thirds.STL
Smarticle Herding/211mm_ring_thirds.STL
Smarticle Herding/220mm_ring.STL
Smarticle Herding/230mm_ring.STL
Smarticle Herding/230mm_ring_thirds.STL
Smarticle Herding/Sawyer_lightHolder.STL
Smarticle Herding/clamping_part.STL
Solidworks/NU-Smarticle Design/vibration motor/vibration motor - washer.SLDPRT
Solidworks/stl Files/Spill_Ring.STL
Solidworks/stl Files/Spill_Ring_small_no_crown.STL
