asamland/NU-Smarticle/NU-Smarticle PCB Design/Eagle Files/feather-v2.0.pdf

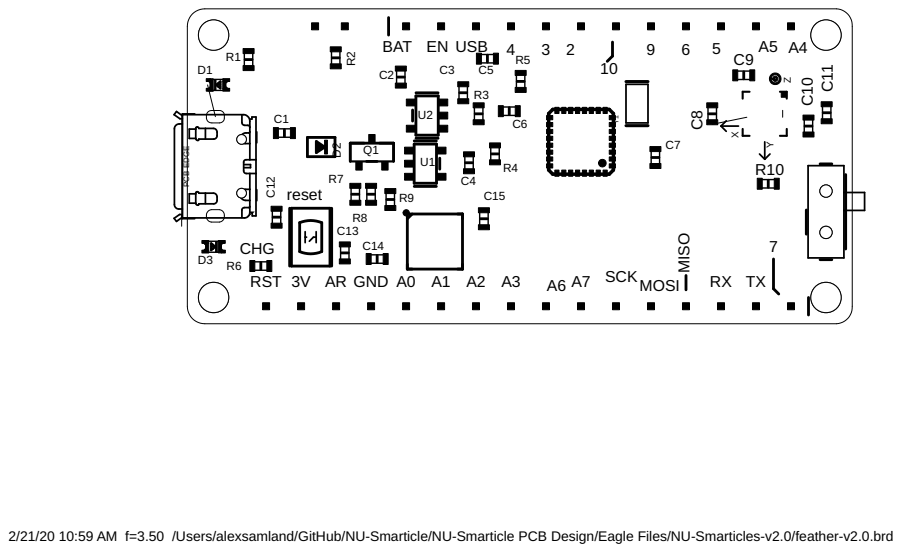
[picture p38: page 1]

2/21/20 10:59 AM f=3.50 /Users/alexsamland/GitHub/NU-Smarticle/NU-Smarticle PCB Design/Eagle Files/NU-Smarticles-v2.0/feather-v2.0.brd
