asamland/NU-Smarticle/NU-Smarticle PCB Design/Eagle Files/NU-Smarticles-v2.0/feather-v2.0.brd

## EAGLE design NU-Smarticle PCB Design/Eagle Files/NU-Smarticles-v2.0/feather-v2.0.brd (2020-03-18)

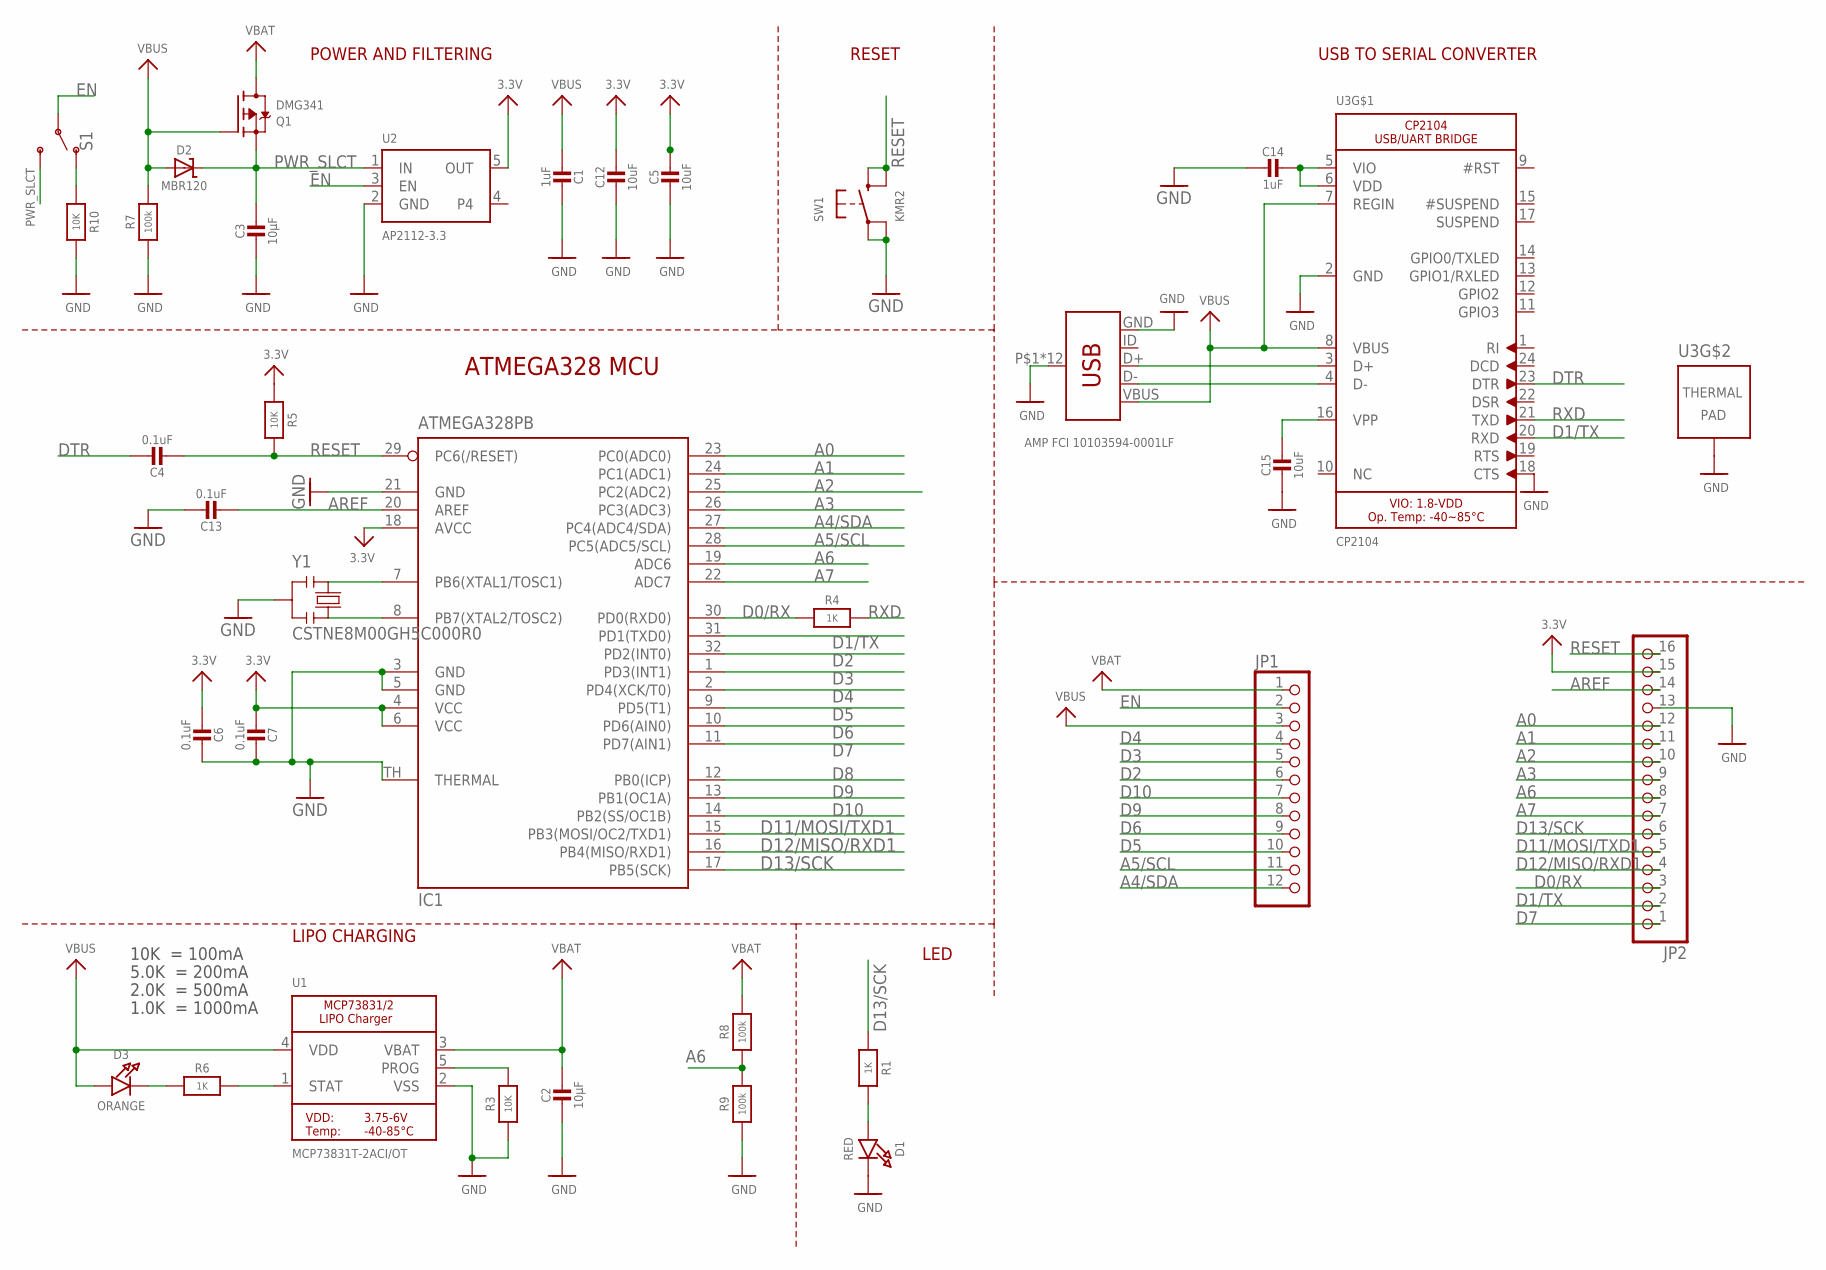
[picture p39: schematic feather-v2.0.sch, sheet 1]

Parts:
C1, C14: 1uF; _0603MP
C2, C3: 10µF; _0603MP
C4, C6, C7, C13: 0.1uF; _0603MP
C5, C12, C15: 10uF; _0603MP
D1: RED; CHIPLED_0603_NOOUTLINE
D2: MBR120; SOD-323
D3: ORANGE; CHIPLED_0603_NOOUTLINE
IC1: ATMEGA328PB; MLF32-TH
JP1: HEADER-1X12; 1X12_ROUND
JP2: HEADER-1X16ROUND; 1X16_ROUND
Q1: DMG341; SOT23-R
R1, R4, R6: 1K; _0603MP
R3, R5, R10: 10K; _0603MP
R7, R8, R9: 100k; _0603MP
S1: SWITCH-SPDT-SMD-RIGHT-ANGLE; SWITCH_SPST_SMD_A
SW1: KMR2; BTN_KMR2_4.6X2.8
U1: MCP73831T-2ACI/OT; SOT23-5
U2: AP2112-3.3; SOT23-5
U3: CP2104; QFN24_4MM_SMSC
X1: AMP FCI 10103594-0001LF; USB-MICROB-PTH
Y1: CSTNE8M00GH5C000R0; RESONATOR

Connections:
3.3V: C5.1, C6.2, C7.2, C12.1, IC1.4 (VCC), IC1.6 (VCC), IC1.18 (AVCC), JP2.15, R5.2, U2.5 (OUT); also elsewhere on the board
A0: IC1.23 (PC0(ADC0)), JP2.12; also elsewhere on the board
A1: IC1.24 (PC1(ADC1)), JP2.11; also elsewhere on the board
A2: IC1.25 (PC2(ADC2)), JP2.10; also elsewhere on the board
A3: IC1.26 (PC3(ADC3)), JP2.9; also elsewhere on the board
A4/SDA: IC1.27 (PC4(ADC4/SDA)), JP1.12; also elsewhere on the board
A5/SCL: IC1.28 (PC5(ADC5/SCL)), JP1.11; also elsewhere on the board
A6: IC1.19 (ADC6), JP2.8, R8.1, R9.2
A7: IC1.22 (ADC7), JP2.7; also elsewhere on the board
AREF: C13.2, IC1.20 (AREF), JP2.14
D0/RX: IC1.30 (PD0(RXD0)), JP2.3, R4.1
D1/TX: IC1.31 (PD1(TXD0)), JP2.2, U3.20 (RXD)
D2: IC1.32 (PD2(INT0)), JP1.6
D3: IC1.1 (PD3(INT1)), JP1.5
D4: IC1.2 (PD4(XCK/T0)), JP1.4
D5: IC1.9 (PD5(T1)), JP1.10
D6: IC1.10 (PD6(AIN0)), JP1.9
D7: IC1.11 (PD7(AIN1)), JP2.1; also elsewhere on the board
D8: IC1.12 (PB0(ICP))
D9: IC1.13 (PB1(OC1A)), JP1.8; also elsewhere on the board
D10: IC1.14 (PB2(SS/OC1B)), JP1.7; also elsewhere on the board
D11/MOSI/TXD1: IC1.15 (PB3(MOSI/OC2/TXD1)), JP2.5; also elsewhere on the board
D12/MISO/RXD1: IC1.16 (PB4(MISO/RXD1)), JP2.4; also elsewhere on the board
D13/SCK: IC1.17 (PB5(SCK)), JP2.6, R1.1
DTR: C4.1, U3.23 (DTR)
EN: JP1.2, S1.2, U2.3 (EN)
GND: C1.1, C2.2, C3.2, C5.2, C6.1, C7.1, C12.2, C13.1, C14.2, C15.2, D1.C, IC1.3 (GND), IC1.5 (GND), IC1.21 (GND), IC1.TH (THERMAL), JP2.13, R3.1, R7.1, R9.1, R10.1, SW1.A, SW1.A' (P1), U1.2 (VSS), U2.2 (GND), U3.2 (GND), U3.18 (CTS), U3.THERM (TP), X1.GND, X1.P$1 (SHIELD), X1.P$2 (SHIELD), X1.P$3 (SHIELD), X1.P$4 (SHIELD), X1.P$6 (SHIELD), X1.P$8 (SHIELD), X1.P$10 (SHIELD), X1.P$12 (SHIELD), X1.SHEILD2 (SHIELD), X1.SHIELD, X1.SHIELD3 (SHIELD), X1.SHIELD4 (SHIELD), Y1.2; also elsewhere on the board
unnamed: D3.C, R6.1
unnamed: U3.3 (D+), X1.D+
unnamed: R6.2, U1.1 (STAT)
unnamed: R3.2, U1.5 (PROG)
unnamed: D1.A, R1.2
unnamed: U3.4 (D-), X1.D-
unnamed: R10.2, S1.1 (O)
unnamed: IC1.8 (PB7(XTAL2/TOSC2)), Y1.3
unnamed: C14.1, U3.5 (VIO), U3.6 (VDD)
unnamed: IC1.7 (PB6(XTAL1/TOSC1)), Y1.1
unnamed: C15.1, U3.16 (VPP)
PWR_SLCT: C3.1, D2.C, Q1.2 (S), S1.3 (S), U2.1 (IN)
RESET: C4.2, IC1.29 (PC6(/RESET)), JP2.16, R5.1, SW1.B (S), SW1.B' (S1)
RXD: R4.2, U3.21 (TXD)
VBAT: C2.1, JP1.1, Q1.3 (D), R8.2, U1.3 (VBAT); also elsewhere on the board
VBUS: C1.2, D2.A, D3.A, JP1.3, Q1.1 (G), R7.2, U1.4 (VDD), U3.7 (REGIN), U3.8 (VBUS), X1.VBUS

Notes on the sheet:
POWER AND FILTERING
RESET
10K = 100mA
5.0K = 200mA
2.0K = 500mA
1.0K = 1000mA
USB TO SERIAL CONVERTER
LIPO CHARGING
LED
ATMEGA328 MCU

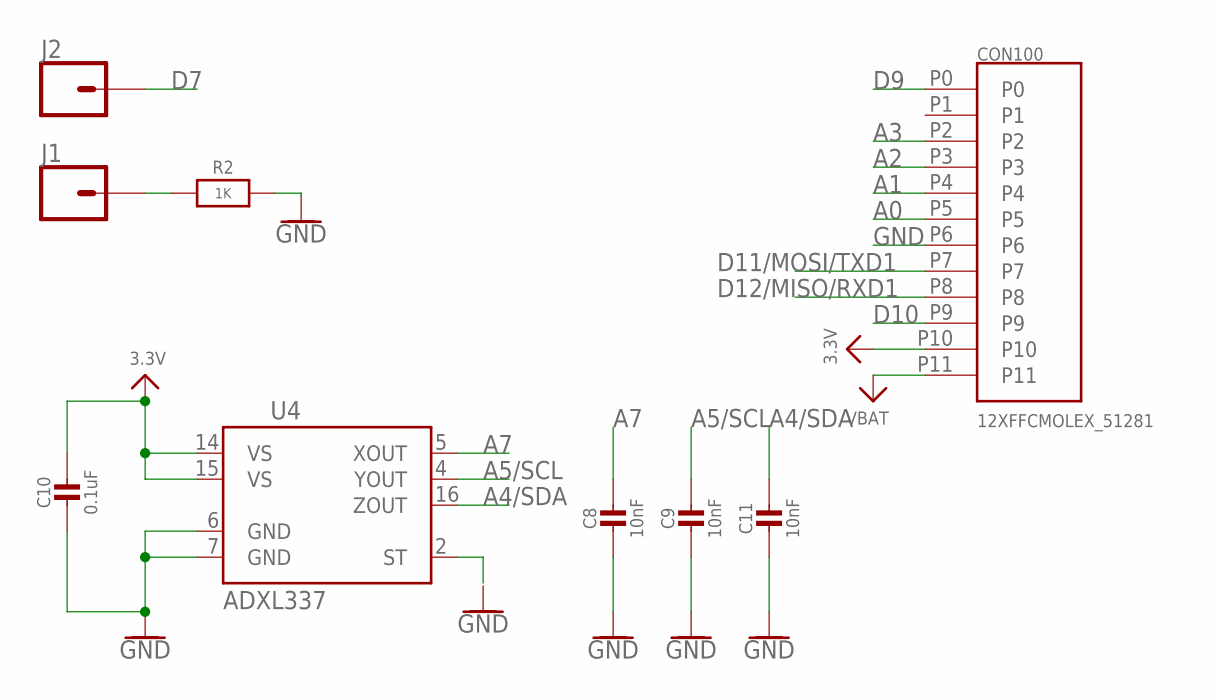
[picture p40: schematic feather-v2.0.sch, sheet 2]

Parts:
C8, C9, C11: 10nF; _0603MP
C10: 0.1uF; _0603MP
CON100: 12XFFCMOLEX_51281; MOLEX_51281-1294
J1, J2: CONN_01PTH_NO_SILK_YES_STOP; 1X01_NO_SILK
R2: 1K; _0603MP
U4: ADXL337; LFCSP_LQ-16

Connections:
3.3V: C10.1, CON100.P10, U4.14 (VS), U4.15 (VS); also elsewhere on the board
A0: CON100.P5; also elsewhere on the board
A1: CON100.P4; also elsewhere on the board
A2: CON100.P3; also elsewhere on the board
A3: CON100.P2; also elsewhere on the board
A4/SDA: C11.1, U4.16 (ZOUT); also elsewhere on the board
A5/SCL: C9.1, U4.4 (YOUT); also elsewhere on the board
A7: C8.1, U4.5 (XOUT); also elsewhere on the board
D7: J2.1; also elsewhere on the board
D9: CON100.P0; also elsewhere on the board
D10: CON100.P9; also elsewhere on the board
D11/MOSI/TXD1: CON100.P7; also elsewhere on the board
D12/MISO/RXD1: CON100.P8; also elsewhere on the board
GND: C8.2, C9.2, C10.2, C11.2, CON100.P6, R2.2, U4.6 (GND), U4.7 (GND); also elsewhere on the board
unnamed: J1.1, R2.1
VBAT: CON100.P11; also elsewhere on the board

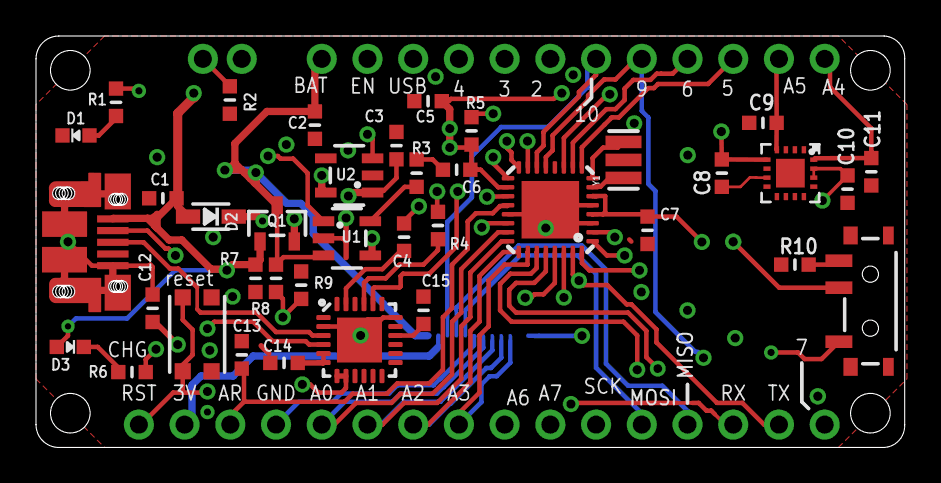
[picture p41: board feather-v2.0.brd from above]

Board: 4 copper layers, 48.3 x 22.9 mm, 43 parts (1 on the bottom side), 43 nets.
