asamland/NU-Smarticle/NU-Smarticle PCB Design/Eagle Files/NU-Smarticles-v2.0/topboard-v2.0.brd

## EAGLE design NU-Smarticle PCB Design/Eagle Files/NU-Smarticles-v2.0/topboard-v2.0.brd (2020-03-18)

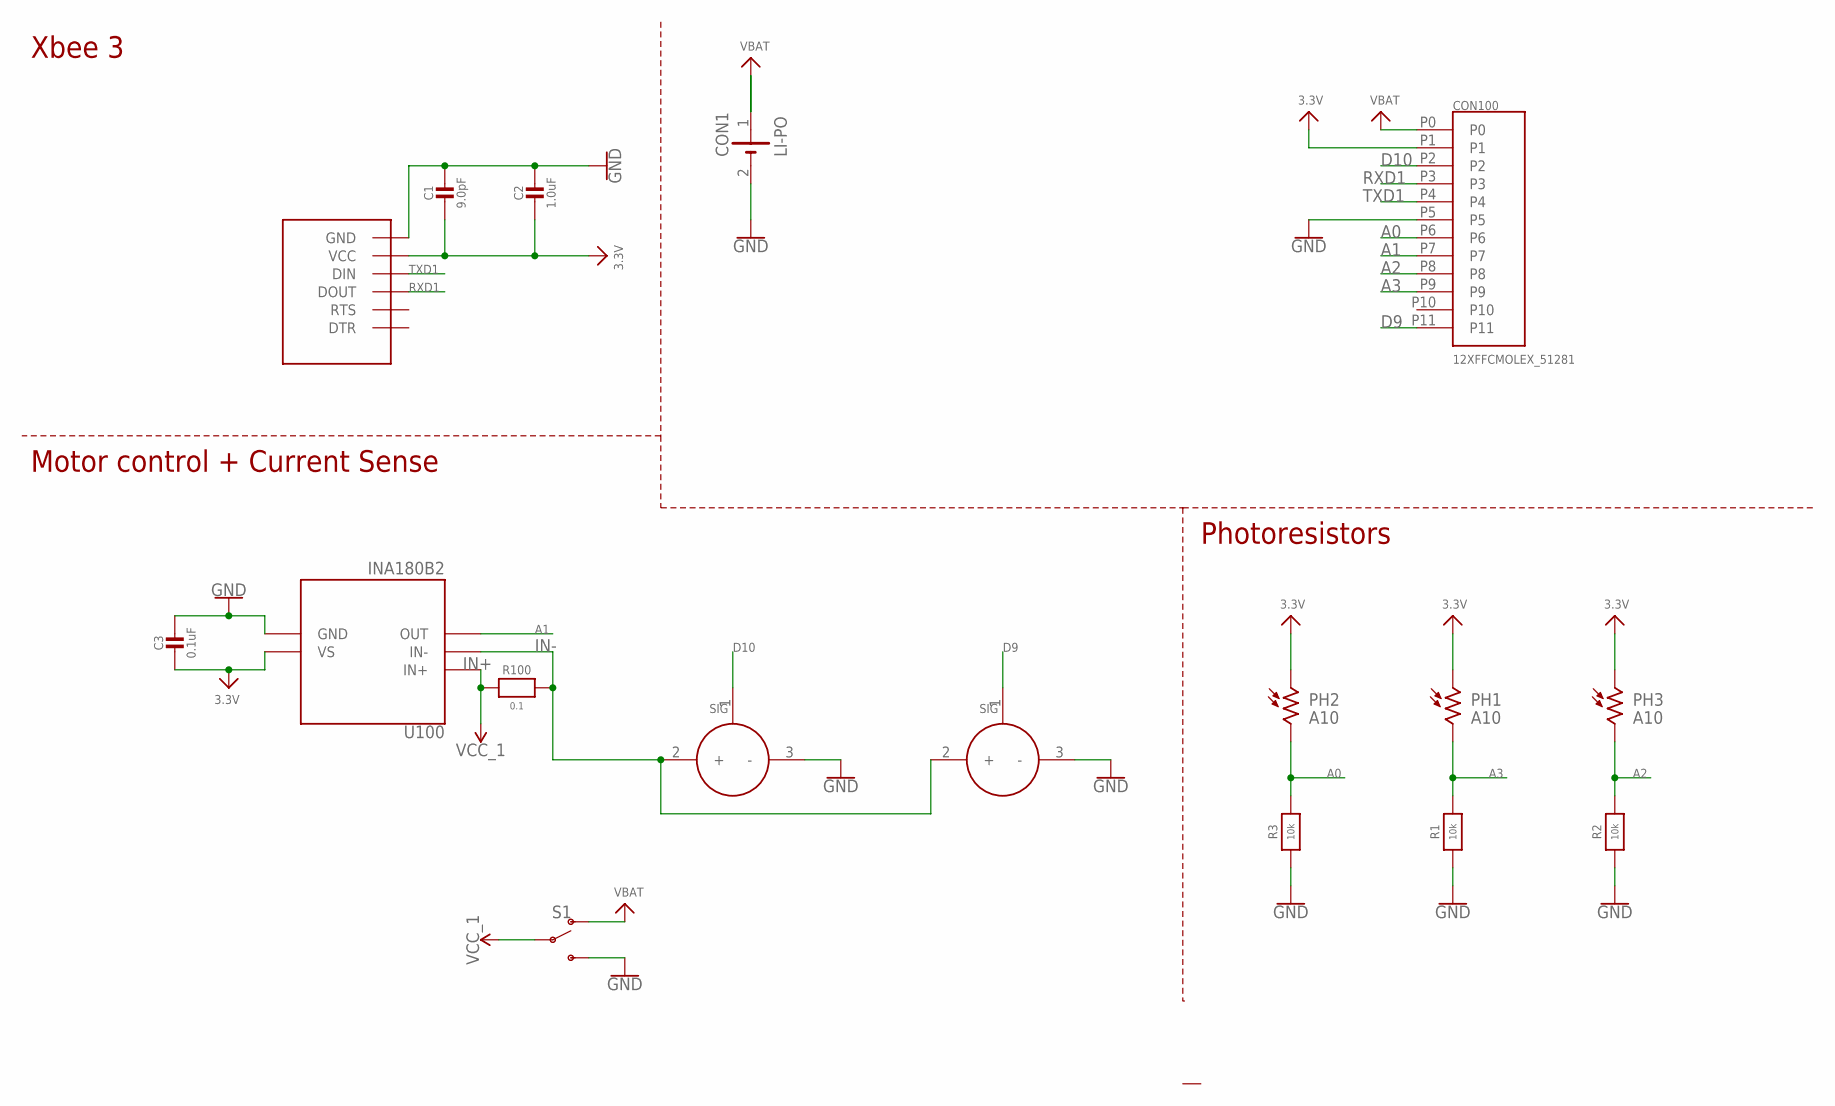
[picture p42: schematic topboard-v2.0.sch]

Parts:
C1: 9.0pF; _0603MP
C2: 1.0uF; _0603MP
C3: 0.1uF; _0603MP
CON1: LI-PO; 1X02_BATT
CON100: 12XFFCMOLEX_51281; MOLEX_51281-1294
M1, M2: SERVO; 1X03_SERVO
PH1, PH2, PH3: A10; PHOTORESISTOR
R1, R2, R3: 10k; _0603MP
R100: 0.1; _0603MP
S1: SWITCH-SPDT-SMD-RIGHT-ANGLE; SWITCH_SPST_SMD_A
U1: XBEE3; XBEE3_MICRO
U100: INA180B2; SOT23-5

Connections:
3.3V: C1.2, C2.2, C3.2, CON100.P1, PH1.1, PH2.1, PH3.1, U1.VCC, U100.5 (VS)
A0: CON100.P6, PH2.2, R3.2
A1: CON100.P7, U100.4 (OUT)
A2: CON100.P8, PH3.2, R2.2
A3: CON100.P9, PH1.2, R1.2
D9: CON100.P11, M1.1 (SIG)
D10: CON100.P2, M2.1 (SIG)
GND: C1.1, C2.1, C3.1, CON1.2 (-), CON100.P5, M1.3 (-), M2.3 (-), R1.1, R2.1, R3.1, S1.3 (S), U1.GND1 (GND), U1.GND2 (GND), U1.GND3 (GND), U1.GND4 (GND), U1.GND5 (GND), U1.GND6 (GND), U100.2 (GND)
IN+: R100.1, U100.1 (IN+)
IN-: M1.2 (+), M2.2 (+), R100.2, U100.3 (IN-)
RXD1: CON100.P3, U1.DOUT/DIO13 (DOUT)
TXD1: CON100.P4, U1.DIN/CONFIG/DIO14 (DIN)
VBAT: CON1.1 (+), CON100.P0, S1.1 (O)
VCC_1: S1.2

Notes on the sheet:
Xbee 3
Photoresistors
Motor control + Current Sense

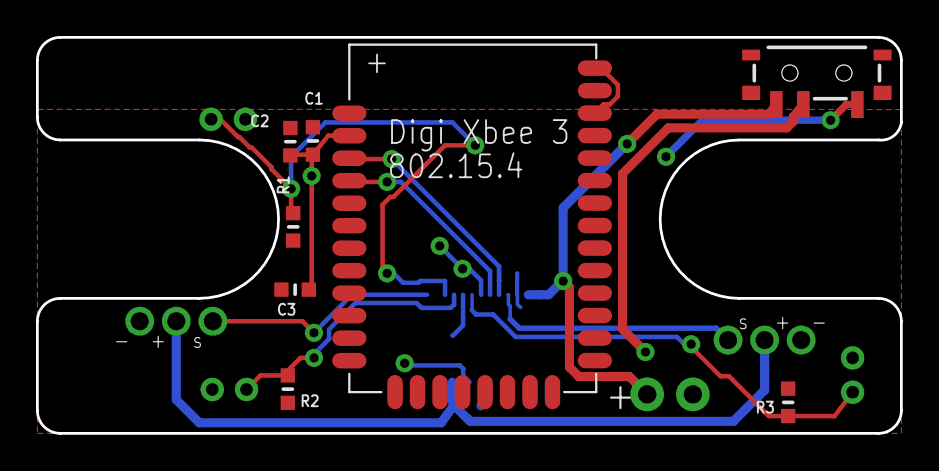
[picture p43: board topboard-v2.0.brd from above]

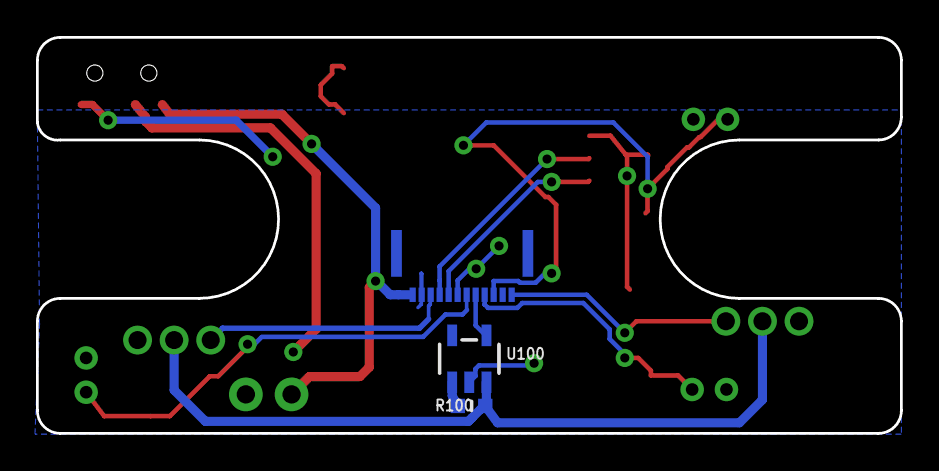
[picture p44: board topboard-v2.0.brd from below]

Board: 2 copper layers, 48.0 x 22.0 mm, 17 parts (3 on the bottom side), 13 nets.
