asamland/NU-Smarticle/NU-Smarticle PCB Design/Eagle Files/Breakouts/ADXL337_Breakout-master/hardware/ADXL337 Breakout.brd

## EAGLE design NU-Smarticle PCB Design/Eagle Files/Breakouts/ADXL337_Breakout-master/hardware/ADXL337 Breakout.brd (2019-10-24)

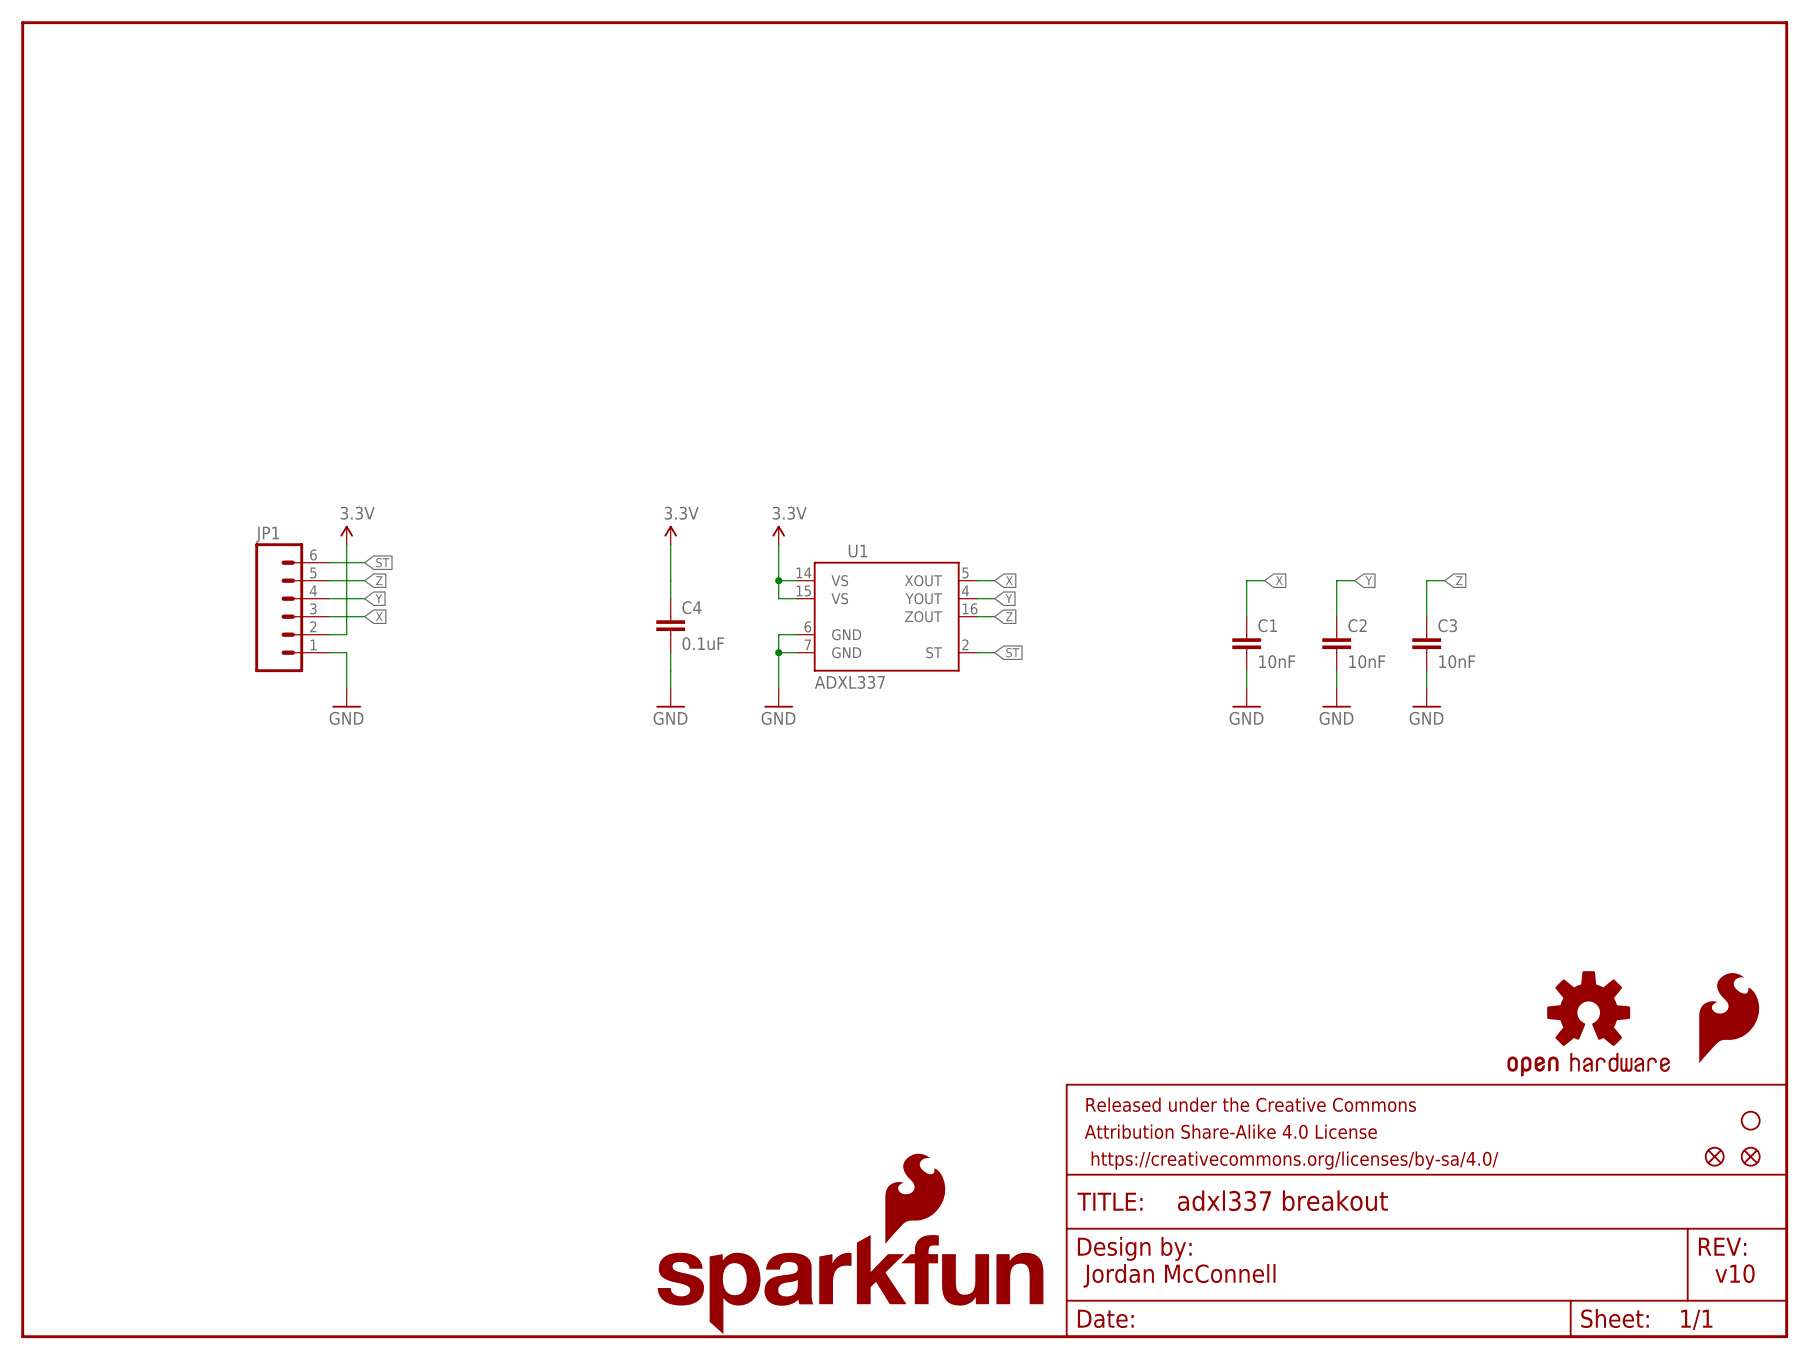
[picture p45: schematic ADXL337 Breakout.sch]

Parts:
C1, C2, C3: 10nF; 0603-CAP
C4: 0.1uF; 0603-CAP
FID1, FID2: FIDUCIAL1X2; FIDUCIAL-1X2
FRAME1: FRAME-LETTER; CREATIVE_COMMONS
JP1: M06SIP; 1X06
LOGO1: SFE_LOGO_FLAME.1_INCH; SFE_LOGO_FLAME_.1
LOGO2: OSHW-LOGOS; OSHW-LOGO-S
LOGO3: SFE_LOGO_NAME_FLAME.1_INCH; SFE_LOGO_NAME_FLAME_.1
STANDOFF1: STAND-OFF
U1: ADXL337; LFCSP_LQ-16

Connections:
3.3V: C4.1, JP1.2, U1.14 (VS), U1.15 (VS)
GND: C1.2, C2.2, C3.2, C4.2, JP1.1, U1.6 (GND), U1.7 (GND)
ST: JP1.6, U1.2 (ST)
X: C1.1, JP1.3, U1.5 (XOUT)
Y: C2.1, JP1.4, U1.4 (YOUT)
Z: C3.1, JP1.5, U1.16 (ZOUT)

Notes on the sheet:
Jordan McConnell
v10

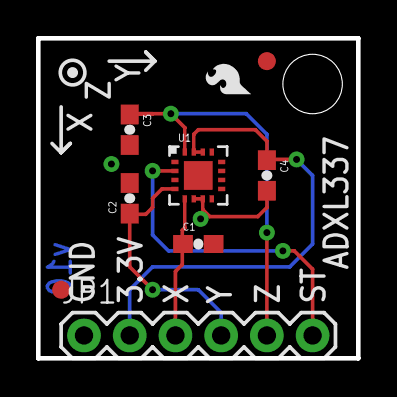
[picture p46: board ADXL337 Breakout.brd from above]

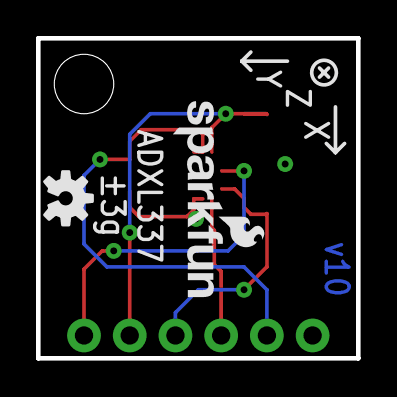
[picture p47: board ADXL337 Breakout.brd from below]

Board: 2 copper layers, 17.8 x 17.8 mm, 13 parts (2 on the bottom side), 6 nets.
