asamland/NU-Smarticle/NU-Smarticle PCB Design/Eagle Files/Breakouts/Adafruit-Feather-328P-PCB/Adafruit Feather 328P.brd

## EAGLE design NU-Smarticle PCB Design/Eagle Files/Breakouts/Adafruit-Feather-328P-PCB/Adafruit Feather 328P.brd (2019-07-25)

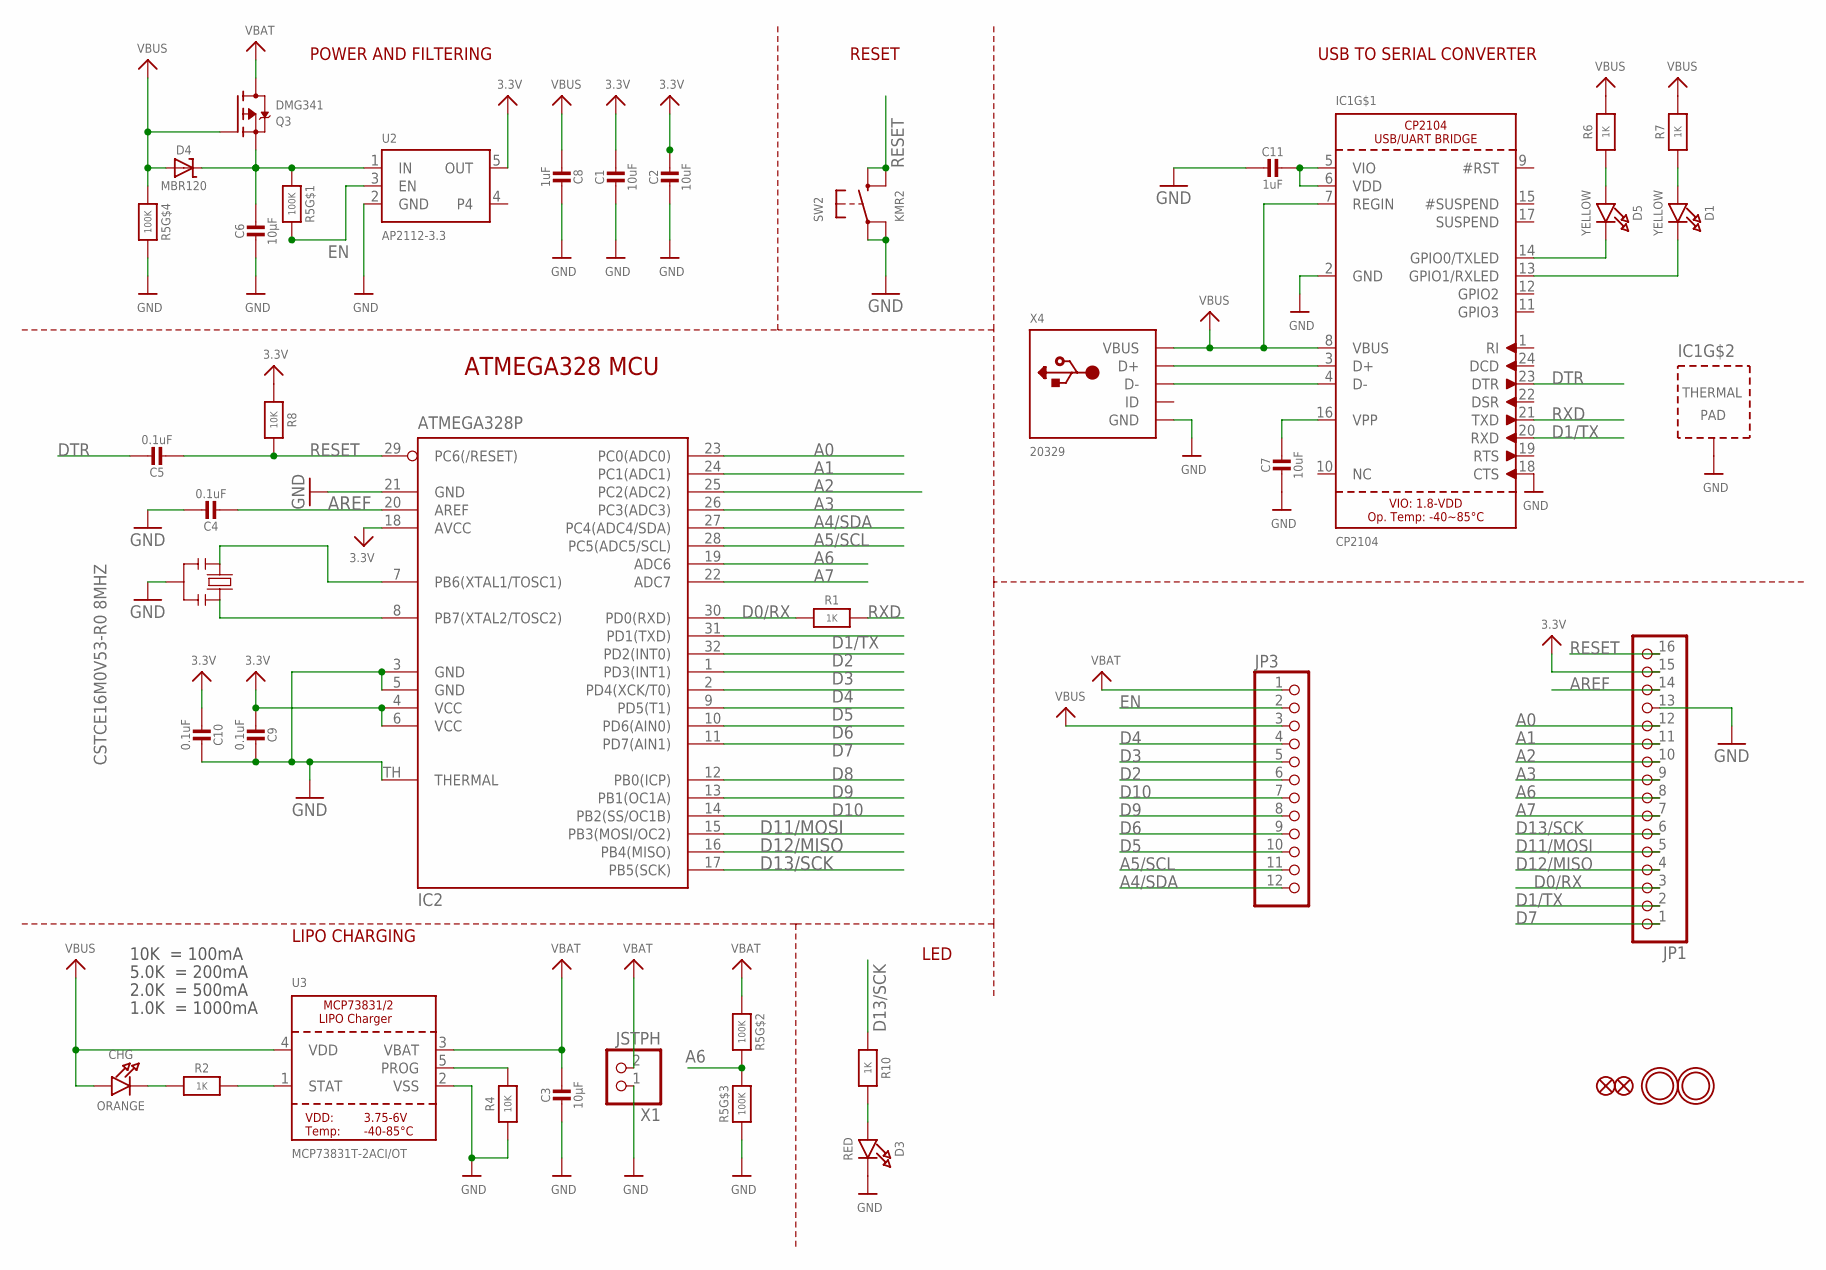
[picture p48: schematic Adafruit Feather 328P.sch]

Parts:
C1, C2: 10uF; 0805-NO
C3, C6: 10µF; 0805-NO
C4, C5, C9, C10: 0.1uF; 0603-NO
C7: 10uF; _0805MP
C8, C11: 1uF; 0603-NO
CHG: ORANGE; CHIPLED_0805_NOOUTLINE
D1, D5: YELLOW; CHIPLED_0805_NOOUTLINE
D3: RED; CHIPLED_0805_NOOUTLINE
D4: MBR120; SOD-123
IC1: CP2104; QFN24_4MM_SMSC
IC2: ATMEGA328P; MLF32-TH
JP1: HEADER-1X16ROUND; 1X16_ROUND
JP3: HEADER-1X12; 1X12_ROUND
Q3: DMG341; SOT23-R
R1: 1K; _0603MP
R2, R6, R7, R10: 1K; 0603-NO
R4, R8: 10K; 0603-NO
R5: 100K; RESPACK_4X0603
SW2: KMR2; BTN_KMR2_4.6X2.8
U2: AP2112-3.3; SOT23-5
U3: MCP73831T-2ACI/OT; SOT23-5
U$31, U$32: MOUNTINGHOLE2.5; MOUNTINGHOLE_2.5_PLATED
U$34, U$35: FIDUCIAL_1MM
X1: JSTPH; JSTPH2
X4: 20329; 4UCONN_20329_V2
Y2: CSTCE16M0V53-R0 8MHZ; RESONATOR

Connections:
3.3V: C1.1, C2.1, C9.2, C10.2, IC2.4 (VCC), IC2.6 (VCC), IC2.18 (AVCC), JP1.15, R8.2, U2.5 (OUT)
A0: IC2.23 (PC0(ADC0)), JP1.12
A1: IC2.24 (PC1(ADC1)), JP1.11
A2: IC2.25 (PC2(ADC2)), JP1.10
A3: IC2.26 (PC3(ADC3)), JP1.9
A4/SDA: IC2.27 (PC4(ADC4/SDA)), JP3.12
A5/SCL: IC2.28 (PC5(ADC5/SCL)), JP3.11
A6: IC2.19 (ADC6), JP1.8, R5.6 (2), R5.7 (2)
A7: IC2.22 (ADC7), JP1.7
AREF: C4.2, IC2.20 (AREF), JP1.14
D0/RX: IC2.30 (PD0(RXD)), JP1.3, R1.1
D1/TX: IC1.20 (RXD), IC2.31 (PD1(TXD)), JP1.2
D2: IC2.32 (PD2(INT0)), JP3.6
D3: IC2.1 (PD3(INT1)), JP3.5
D4: IC2.2 (PD4(XCK/T0)), JP3.4
D5: IC2.9 (PD5(T1)), JP3.10
D6: IC2.10 (PD6(AIN0)), JP3.9
D7: IC2.11 (PD7(AIN1)), JP1.1
D8: IC2.12 (PB0(ICP))
D9: IC2.13 (PB1(OC1A)), JP3.8
D10: IC2.14 (PB2(SS/OC1B)), JP3.7
D11/MOSI: IC2.15 (PB3(MOSI/OC2)), JP1.5
D12/MISO: IC2.16 (PB4(MISO)), JP1.4
D13/SCK: IC2.17 (PB5(SCK)), JP1.6, R10.1
DTR: C5.1, IC1.23 (DTR)
EN: JP3.2, R5.8 (2), U2.3 (EN)
GND: C1.2, C2.2, C3.2, C4.1, C6.2, C7.2, C8.1, C9.1, C10.1, C11.2, D3.C, IC1.2 (GND), IC1.18 (CTS), IC1.THERM (TP), IC2.3 (GND), IC2.5 (GND), IC2.21 (GND), IC2.TH (THERMAL), JP1.13, R4.1, R5.3 (1), R5.5 (2), SW2.A, SW2.A' (P1), U2.2 (GND), U3.2 (VSS), X1.1, X4.BASE@1 (GND), X4.BASE@2 (GND), X4.GND, X4.SPRT@1 (GND), X4.SPRT@2 (GND), X4.SPRT@3 (GND), X4.SPRT@4 (GND), Y2.2
unnamed: CHG.C, R2.1
unnamed: IC1.3 (D+), X4.D+
unnamed: R2.2, U3.1 (STAT)
unnamed: R4.2, U3.5 (PROG)
unnamed: D3.A, R10.2
unnamed: IC1.4 (D-), X4.D-
unnamed: C6.1, D4.C, Q3.2 (S), R5.1, U2.1 (IN)
unnamed: D1.A, R7.1
unnamed: D5.A, R6.1
unnamed: C11.1, IC1.5 (VIO), IC1.6 (VDD)
unnamed: C7.1, IC1.16 (VPP)
RESET: C5.2, IC2.29 (PC6(/RESET)), JP1.16, R8.1, SW2.B (S), SW2.B' (S1)
RXD: IC1.21 (TXD), R1.2
RXLED: D1.C, IC1.13 (GPIO1/RXLED)
TXLED: D5.C, IC1.14 (GPIO0/TXLED)
VBAT: C3.1, JP3.1, Q3.3 (D), R5.2 (1), U3.3 (VBAT), X1.2
VBUS: C8.2, CHG.A, D4.A, IC1.7 (REGIN), IC1.8 (VBUS), JP3.3, Q3.1 (G), R5.4 (1), R6.2, R7.2, U3.4 (VDD), X4.VBUS
XTAL1: IC2.8 (PB7(XTAL2/TOSC2)), Y2.3
XTAL2: IC2.7 (PB6(XTAL1/TOSC1)), Y2.1

Notes on the sheet:
POWER AND FILTERING
RESET
10K = 100mA
5.0K = 200mA
2.0K = 500mA
1.0K = 1000mA
USB TO SERIAL CONVERTER
LIPO CHARGING
LED
ATMEGA328 MCU

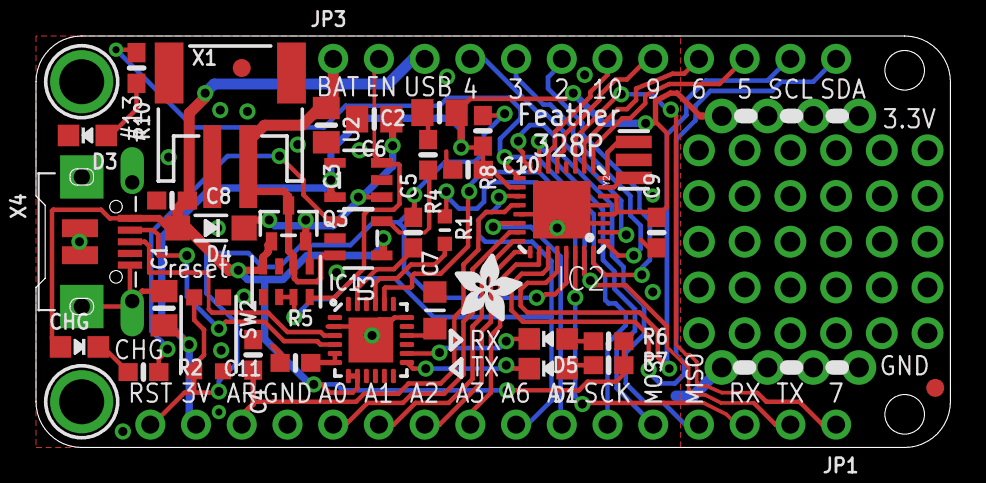
[picture p49: board Adafruit Feather 328P.brd from above]

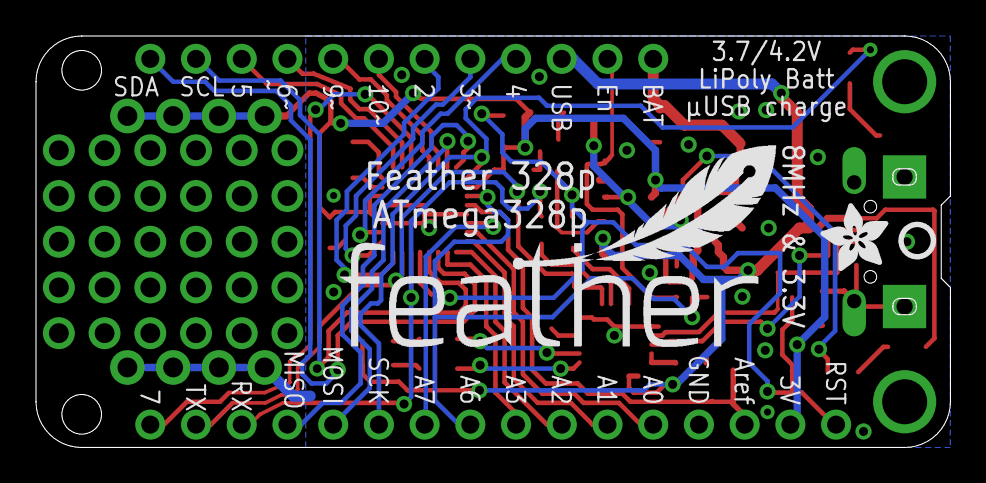
[picture p50: board Adafruit Feather 328P.brd from below]

Board: 2 copper layers, 50.8 x 22.9 mm, 43 parts (3 on the bottom side), 45 nets.

Other parts of the board:
U$9: FEATHERLOGO
U$13: PCBFEAT-REV-040
U$15, U$44: ADAFRUIT_3.5MM
