asamland/NU-Smarticle/NU-Smarticle PCB Design/Eagle Files/NU-Smarticles-v1.0/feather-v1.brd

## EAGLE design NU-Smarticle PCB Design/Eagle Files/NU-Smarticles-v1.0/feather-v1.brd (2019-07-25, an earlier design)

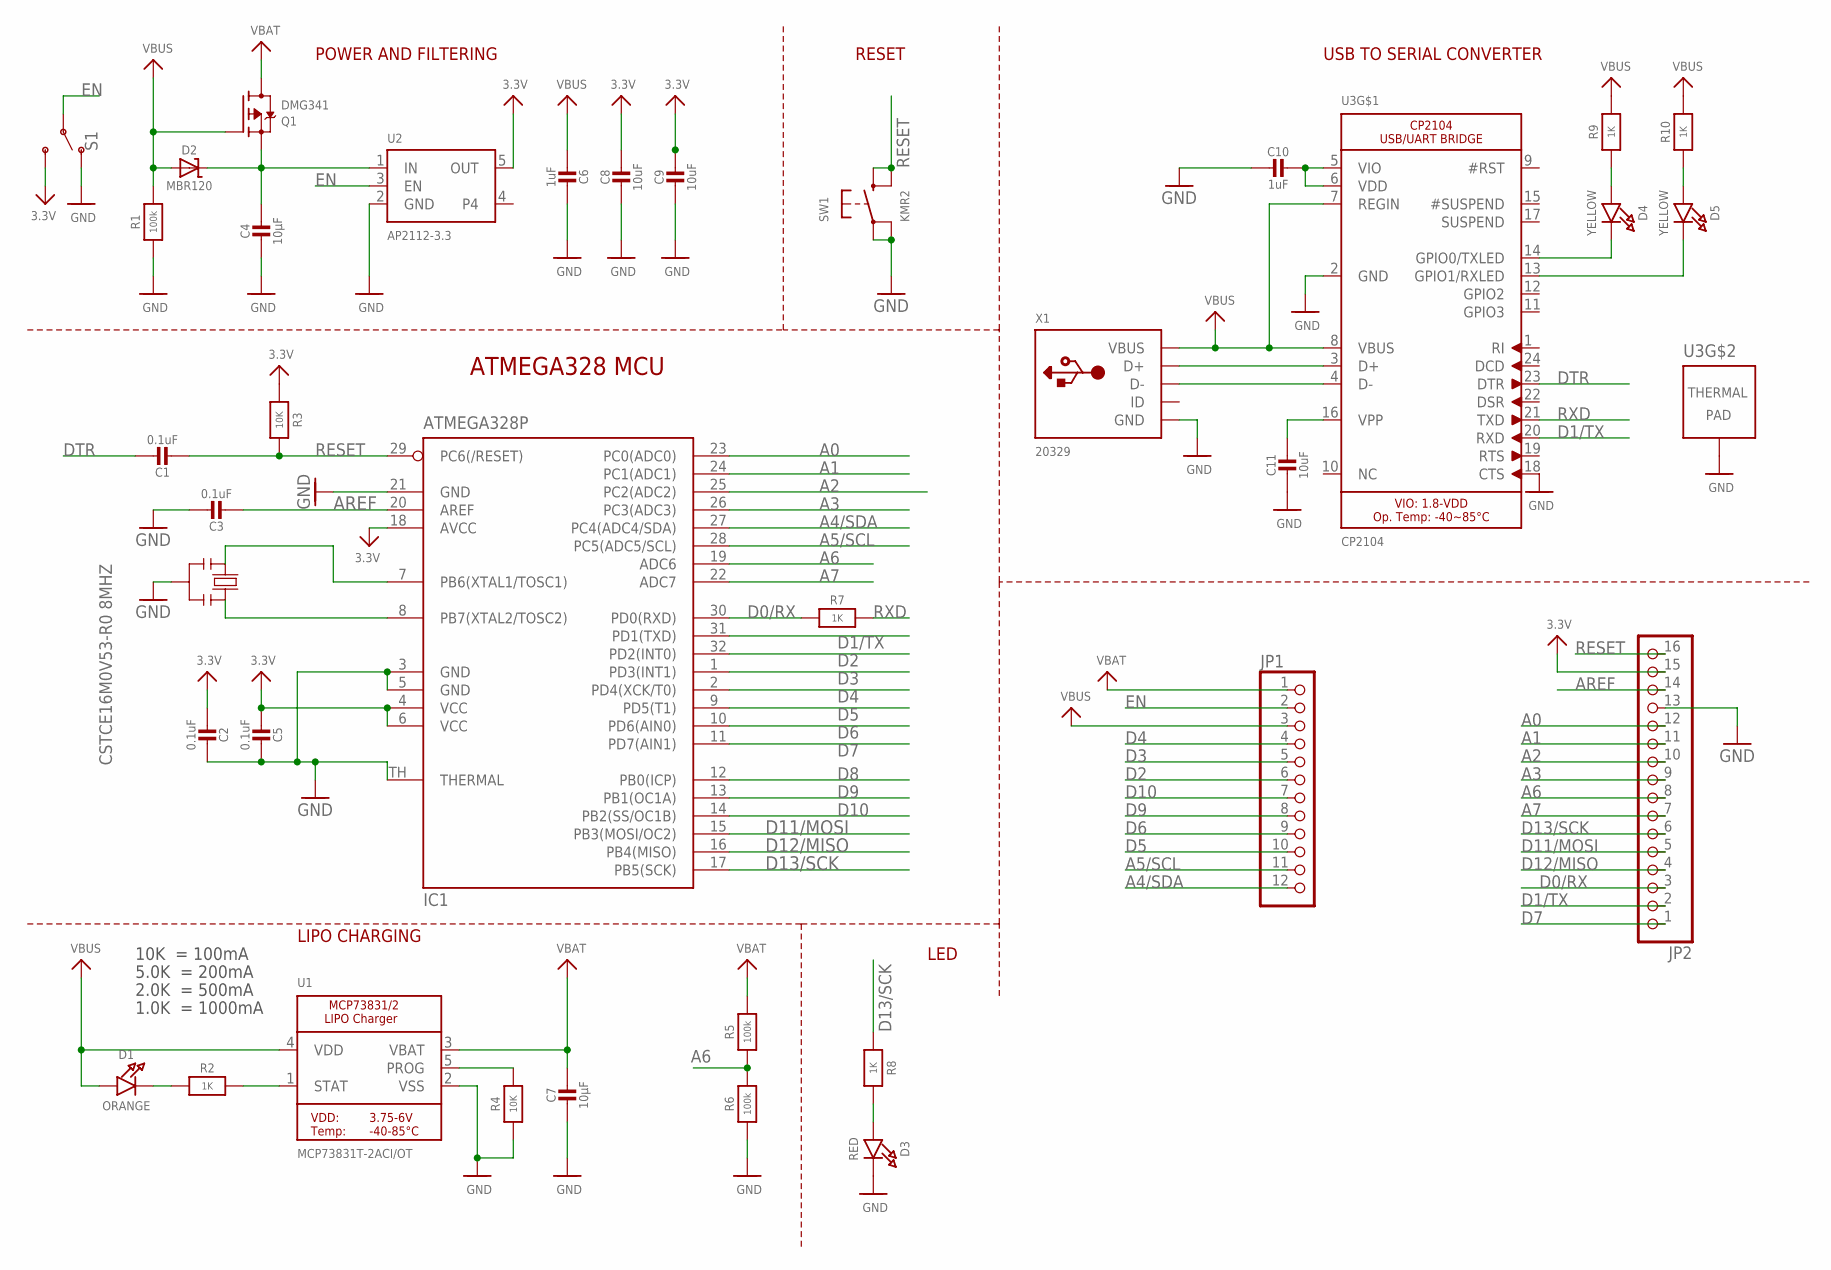
[picture p51: schematic feather-v1.sch, sheet 1]

Parts:
C1, C2, C3, C5: 0.1uF; _0603MP
C4, C7: 10µF; _0603MP
C6, C10: 1uF; _0603MP
C8, C9, C11: 10uF; _0603MP
D1: ORANGE; CHIPLED_0603_NOOUTLINE
D2: MBR120; SOD-523
D3: RED; CHIPLED_0603_NOOUTLINE
D4, D5: YELLOW; CHIPLED_0603_NOOUTLINE
IC1: ATMEGA328P; MLF32-TH
JP1: HEADER-1X12; 1X12_ROUND
JP2: HEADER-1X16ROUND; 1X16_ROUND
Q1: DMG341; SOT23-R
R1, R5, R6: 100k; _0603MP
R2, R7, R8, R9, R10: 1K; _0603MP
R3, R4: 10K; _0603MP
S1: SWITCH-SPDT-SMD-RIGHT-ANGLE; SWITCH_SPST_SMD_A
SW1: KMR2; BTN_KMR2_4.6X2.8
U1: MCP73831T-2ACI/OT; SOT23-5
U2: AP2112-3.3; SOT23-5
U3: CP2104; QFN24_4MM_SMSC
X1: 20329; 4UCONN_20329_V2
Y1: CSTCE16M0V53-R0 8MHZ; RESONATOR

Connections:
3.3V: C2.2, C5.2, C8.1, C9.1, IC1.4 (VCC), IC1.6 (VCC), IC1.18 (AVCC), JP2.15, R3.2, S1.3 (S), U2.5 (OUT); also elsewhere on the board
A0: IC1.23 (PC0(ADC0)), JP2.12; also elsewhere on the board
A1: IC1.24 (PC1(ADC1)), JP2.11; also elsewhere on the board
A2: IC1.25 (PC2(ADC2)), JP2.10; also elsewhere on the board
A3: IC1.26 (PC3(ADC3)), JP2.9; also elsewhere on the board
A4/SDA: IC1.27 (PC4(ADC4/SDA)), JP1.12
A5/SCL: IC1.28 (PC5(ADC5/SCL)), JP1.11
A6: IC1.19 (ADC6), JP2.8, R5.1, R6.2
A7: IC1.22 (ADC7), JP2.7
AREF: C3.2, IC1.20 (AREF), JP2.14
D0/RX: IC1.30 (PD0(RXD)), JP2.3, R7.1
D1/TX: IC1.31 (PD1(TXD)), JP2.2, U3.20 (RXD)
D2: IC1.32 (PD2(INT0)), JP1.6; also elsewhere on the board
D3: IC1.1 (PD3(INT1)), JP1.5; also elsewhere on the board
D4: IC1.2 (PD4(XCK/T0)), JP1.4; also elsewhere on the board
D5: IC1.9 (PD5(T1)), JP1.10
D6: IC1.10 (PD6(AIN0)), JP1.9
D7: IC1.11 (PD7(AIN1)), JP2.1; also elsewhere on the board
D8: IC1.12 (PB0(ICP))
D9: IC1.13 (PB1(OC1A)), JP1.8
D10: IC1.14 (PB2(SS/OC1B)), JP1.7; also elsewhere on the board
D11/MOSI: IC1.15 (PB3(MOSI/OC2)), JP2.5
D12/MISO: IC1.16 (PB4(MISO)), JP2.4
D13/SCK: IC1.17 (PB5(SCK)), JP2.6, R8.1
DTR: C1.1, U3.23 (DTR)
EN: JP1.2, S1.2, U2.3 (EN)
GND: C2.1, C3.1, C4.2, C5.1, C6.1, C7.2, C8.2, C9.2, C10.2, C11.2, D3.C, IC1.3 (GND), IC1.5 (GND), IC1.21 (GND), IC1.TH (THERMAL), JP2.13, R1.1, R4.1, R6.1, S1.1 (O), SW1.A, SW1.A' (P1), U1.2 (VSS), U2.2 (GND), U3.2 (GND), U3.18 (CTS), U3.THERM (TP), X1.BASE@1 (GND), X1.BASE@2 (GND), X1.GND, X1.SPRT@1 (GND), X1.SPRT@2 (GND), X1.SPRT@3 (GND), X1.SPRT@4 (GND), Y1.2; also elsewhere on the board
unnamed: D1.C, R2.1
unnamed: U3.3 (D+), X1.D+
unnamed: R2.2, U1.1 (STAT)
unnamed: R4.2, U1.5 (PROG)
unnamed: D3.A, R8.2
unnamed: U3.4 (D-), X1.D-
unnamed: C4.1, D2.K (C), Q1.2 (S), U2.1 (IN)
unnamed: D5.A, R10.1
unnamed: D4.A, R9.1
unnamed: C10.1, U3.5 (VIO), U3.6 (VDD)
unnamed: C11.1, U3.16 (VPP)
RESET: C1.2, IC1.29 (PC6(/RESET)), JP2.16, R3.1, SW1.B (S), SW1.B' (S1)
RXD: R7.2, U3.21 (TXD)
RXLED: D5.C, U3.13 (GPIO1/RXLED)
TXLED: D4.C, U3.14 (GPIO0/TXLED)
VBAT: C7.1, JP1.1, Q1.3 (D), R5.2, U1.3 (VBAT); also elsewhere on the board
VBUS: C6.2, D1.A, D2.A, JP1.3, Q1.1 (G), R1.2, R9.2, R10.2, U1.4 (VDD), U3.7 (REGIN), U3.8 (VBUS), X1.VBUS
XTAL1: IC1.8 (PB7(XTAL2/TOSC2)), Y1.3
XTAL2: IC1.7 (PB6(XTAL1/TOSC1)), Y1.1

Notes on the sheet:
POWER AND FILTERING
RESET
10K = 100mA
5.0K = 200mA
2.0K = 500mA
1.0K = 1000mA
USB TO SERIAL CONVERTER
LIPO CHARGING
LED
ATMEGA328 MCU
