asamland/NU-Smarticle/NU-Smarticle PCB Design/Eagle Files/NU-Smarticles-v1.0/feather-v1.brd

## EAGLE design NU-Smarticle PCB Design/Eagle Files/NU-Smarticles-v1.0/feather-v1.brd (continued)

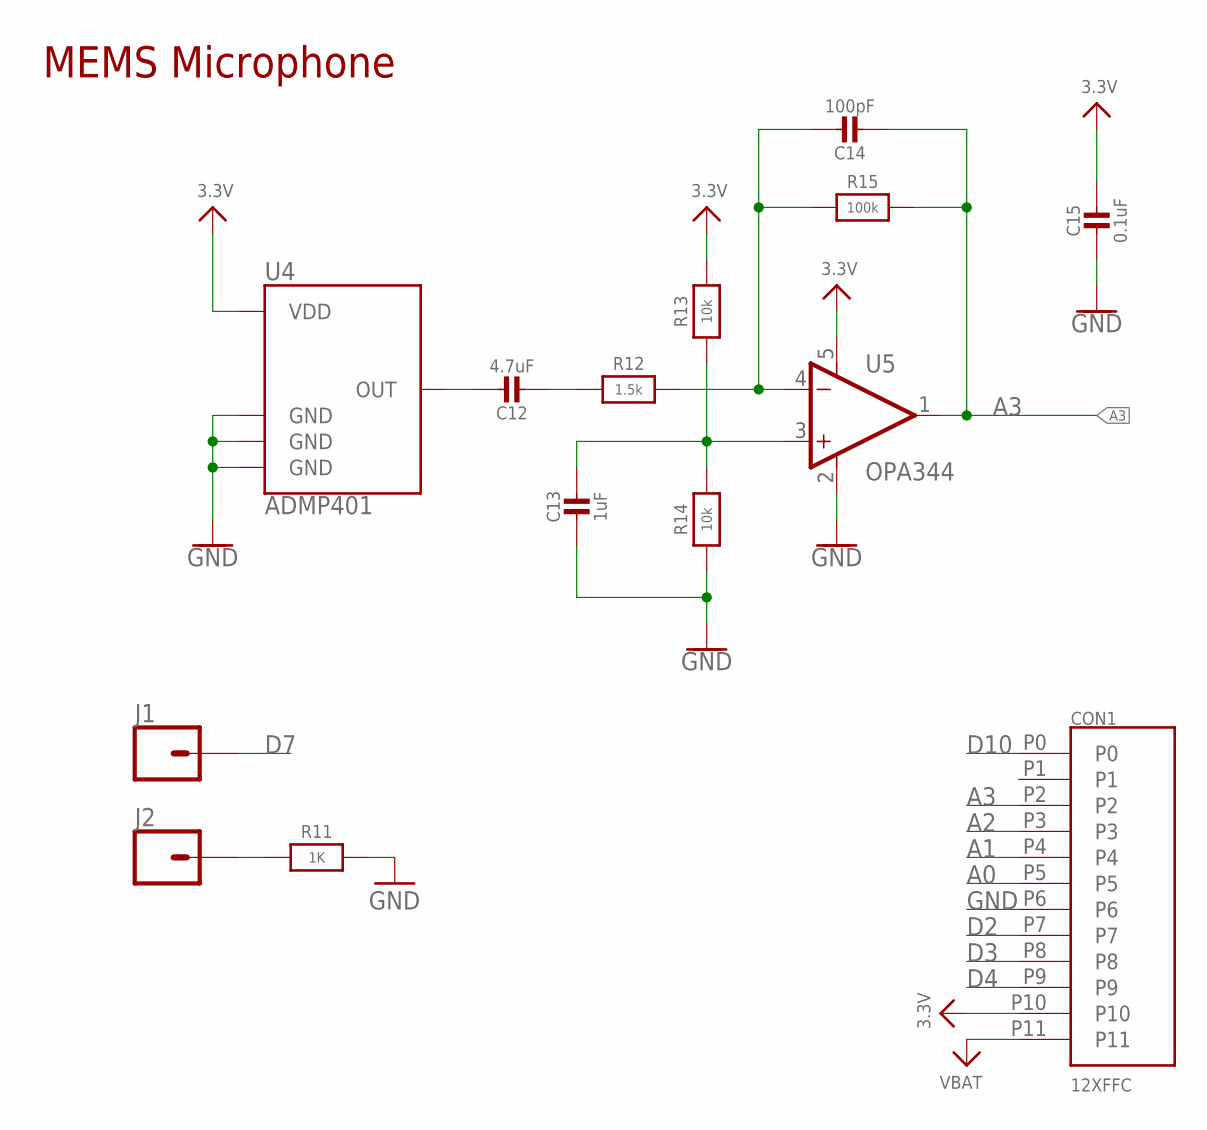
[picture p52: schematic feather-v1.sch, sheet 2]

Parts:
C12: 4.7uF; _0603MP
C13: 1uF; _0603MP
C14: 100pF; _0603MP
C15: 0.1uF; _0603MP
CON1: 12XFFC; 15166-0117
J1, J2: CONN_01PTH_NO_SILK_YES_STOP; 1X01_NO_SILK
R11: 1K; _0603MP
R12: 1.5k; _0603MP
R13, R14: 10k; _0603MP
R15: 100k; _0603MP
U4: ADMP401
U5: OPA344; SOT23-5

Connections:
3.3V: C15.1, CON1.P10, R13.2, U4.5 (VDD), U5.5 (V+); also elsewhere on the board
A0: CON1.P5; also elsewhere on the board
A1: CON1.P4; also elsewhere on the board
A2: CON1.P3; also elsewhere on the board
A3: C14.2, CON1.P2, R15.2, U5.1 (OUT); also elsewhere on the board
D2: CON1.P7; also elsewhere on the board
D3: CON1.P8; also elsewhere on the board
D4: CON1.P9; also elsewhere on the board
D7: J1.1; also elsewhere on the board
D10: CON1.P0; also elsewhere on the board
GND: C13.2, C15.2, CON1.P6, R11.2, R14.1, U4.2 (GND), U4.4 (GND), U4.6 (GND), U5.2 (V-); also elsewhere on the board
unnamed: J2.1, R11.1
unnamed: C12.1, U4.1 (OUT)
unnamed: C14.1, R12.2, R15.1, U5.4 (-IN)
unnamed: C12.2, R12.1
unnamed: C13.1, R13.1, R14.2, U5.3 (+IN)
VBAT: CON1.P11; also elsewhere on the board

Notes on the sheet:
MEMS Microphone

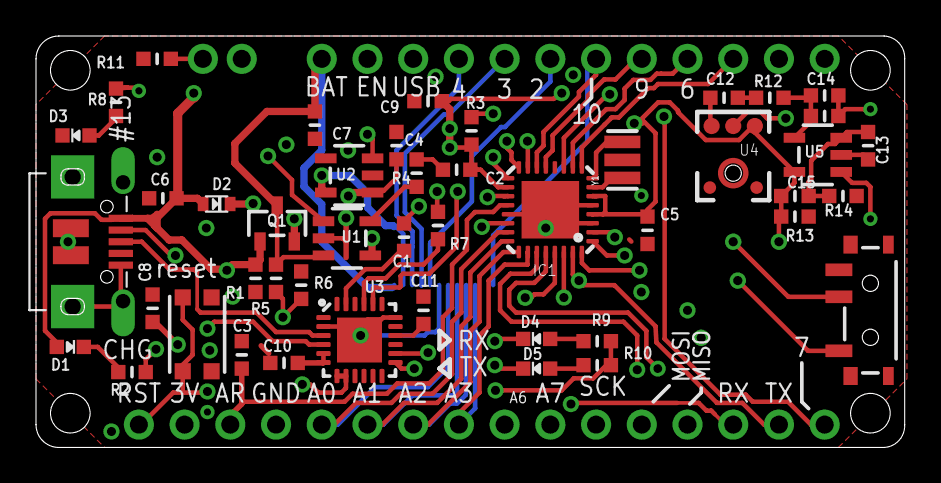
[picture p53: board feather-v1.brd from above]

Board: 4 copper layers, 48.3 x 22.9 mm, 51 parts (1 on the bottom side), 50 nets.
