asamland/NU-Smarticle/NU-Smarticle PCB Design/Eagle Files/Breakouts/ADXL337_Breakout-master/Production Files/ADXL337 Breakout-Panel-v10.brd

## EAGLE design NU-Smarticle PCB Design/Eagle Files/Breakouts/ADXL337_Breakout-master/Production Files/ADXL337 Breakout-Panel-v10.brd (2019-10-24)

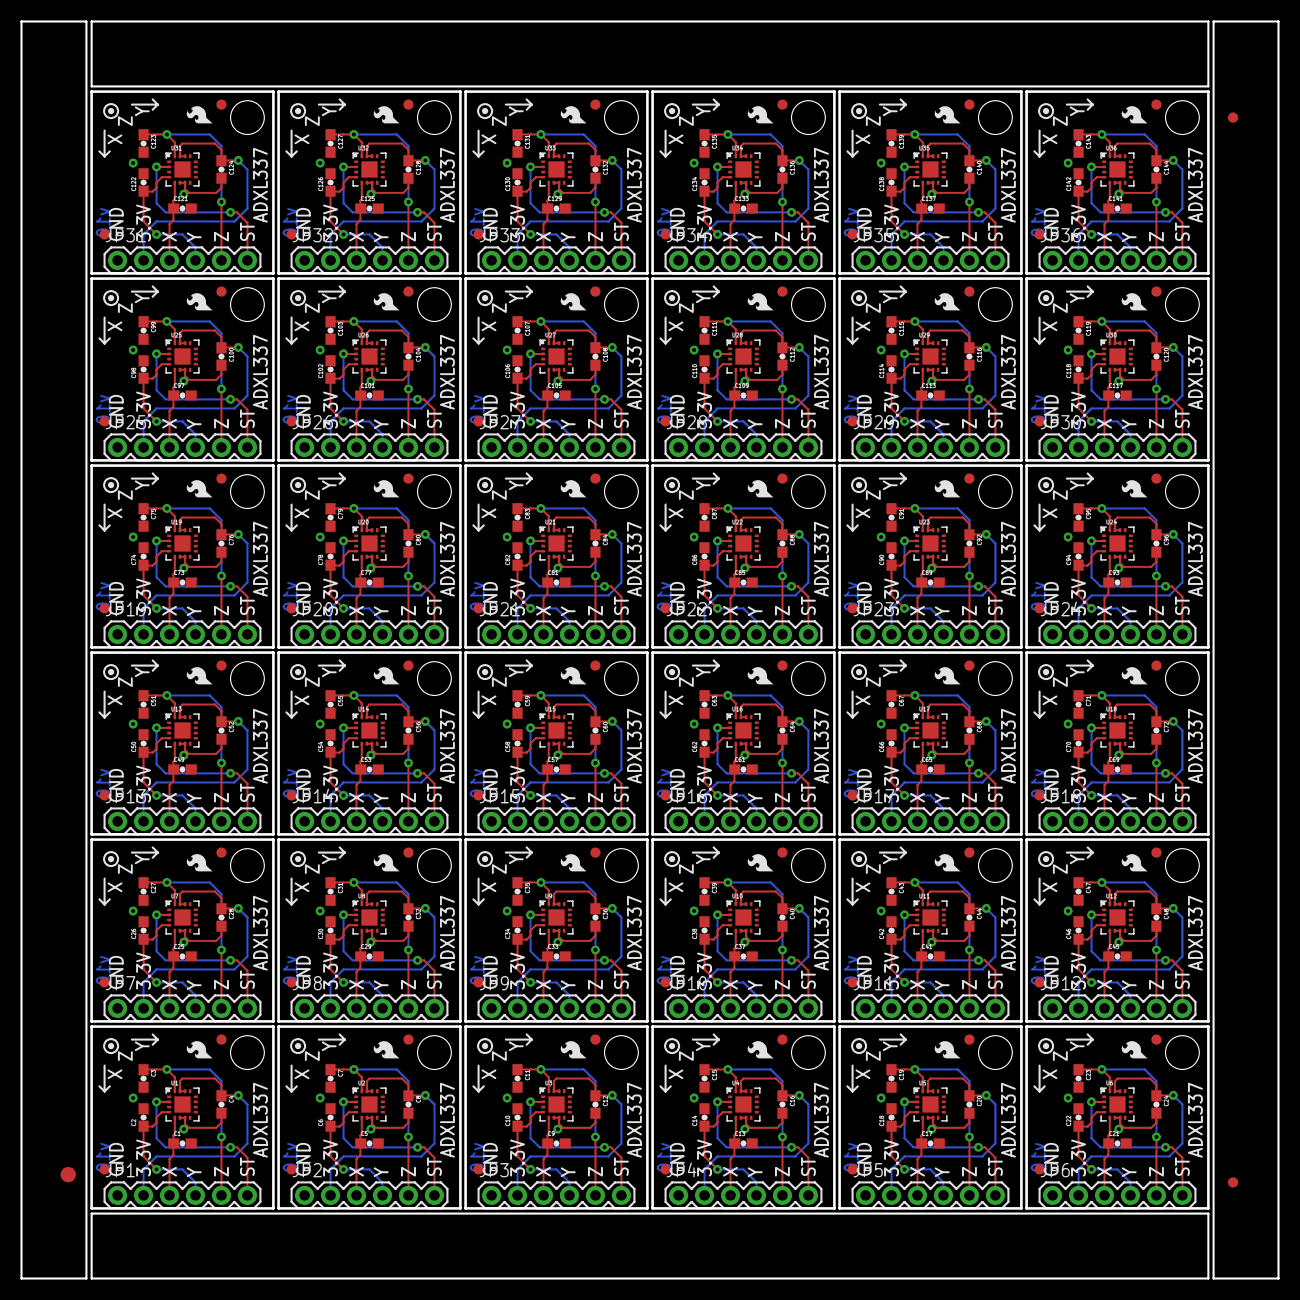
[picture p54: board ADXL337 Breakout-Panel-v10.brd from above]

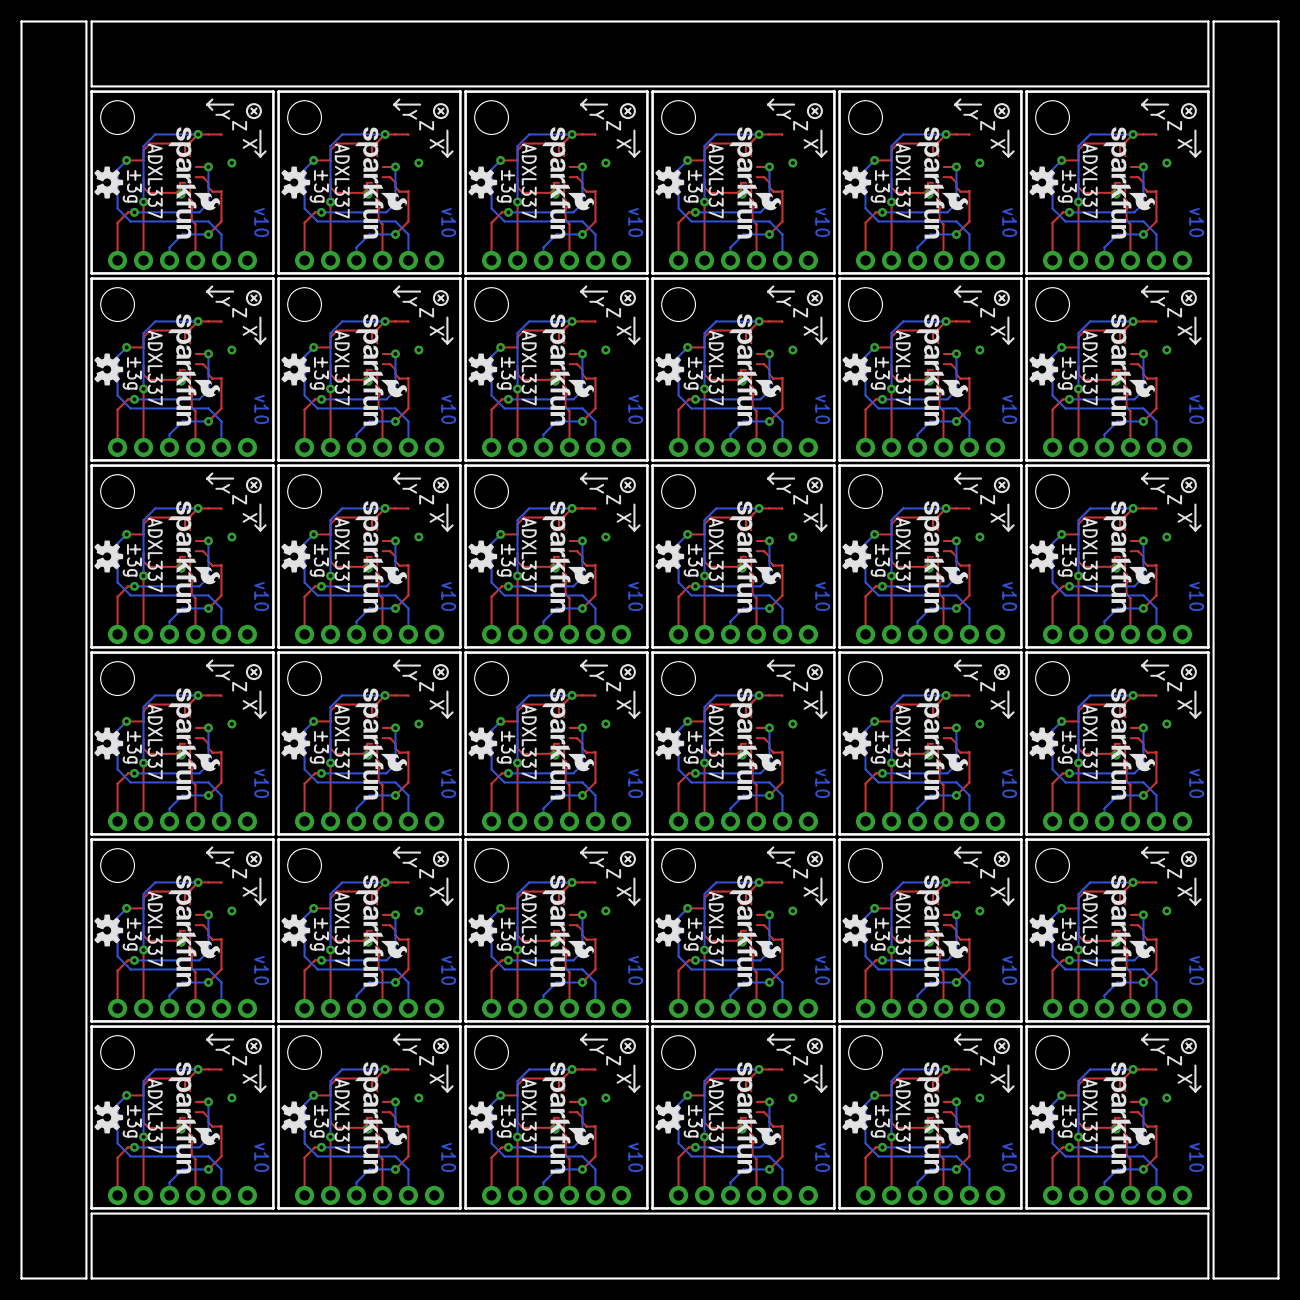
[picture p55: board ADXL337 Breakout-Panel-v10.brd from below]

Board: 2 copper layers, 122.9 x 122.9 mm, 435 parts (72 on the bottom side), 216 nets.

Parts:
C1, C2, C3, C5, C6, C7, C9, C10, C11, C13, C14, C15, C17, C18, C19, C21, C22, C23, C25, C26, C27, C29, C30, C31, C33, C34, C35, C37, C38, C39, C41, C42, C43, C45, C46, C47, C49, C50, C51, C53, C54, C55, C57, C58, C59, C61, C62, C63, C65, C66, C67, C69, C70, C71, C73, C74, C75, C77, C78, C79, C81, C82, C83, C85, C86, C87, C89, C90, C91, C93, C94, C95, C97, C98, C99, C101, C102, C103, C105, C106, C107, C109, C110, C111, C113, C114, C115, C117, C118, C119, C121, C122, C123, C125, C126, C127, C129, C130, C131, C133, C134, C135, C137, C138, C139, C141, C142, C143: 10nF; 0603-CAP
C4, C8, C12, C16, C20, C24, C28, C32, C36, C40, C44, C48, C52, C56, C60, C64, C68, C72, C76, C80, C84, C88, C92, C96, C100, C104, C108, C112, C116, C120, C124, C128, C132, C136, C140, C144: 0.1uF; 0603-CAP
E$1: FIDUCIAL-1.5X3
E$4, E$6: FIDUCIAL-1X2
FID1, FID2, FID3, FID4, FID5, FID6, FID7, FID8, FID9, FID10, FID11, FID12, FID13, FID14, FID15, FID16, FID17, FID18, FID19, FID20, FID21, FID22, FID23, FID24, FID25, FID26, FID27, FID28, FID29, FID30, FID31, FID32, FID33, FID34, FID35, FID36, FID37, FID38, FID39, FID40, FID41, FID42, FID43, FID44, FID45, FID46, FID47, FID48, FID49, FID50, FID51, FID52, FID53, FID54, FID55, FID56, FID57, FID58, FID59, FID60, FID61, FID62, FID63, FID64, FID65, FID66, FID67, FID68, FID69, FID70, FID71, FID72: FIDUCIAL1X2; FIDUCIAL-1X2
JP1, JP2, JP3, JP4, JP5, JP6, JP7, JP8, JP9, JP10, JP11, JP12, JP13, JP14, JP15, JP16, JP17, JP18, JP19, JP20, JP21, JP22, JP23, JP24, JP25, JP26, JP27, JP28, JP29, JP30, JP31, JP32, JP33, JP34, JP35, JP36: 1X06
LOGO1, LOGO4, LOGO7, LOGO10, LOGO13, LOGO16, LOGO19, LOGO22, LOGO25, LOGO28, LOGO31, LOGO34, LOGO37, LOGO40, LOGO43, LOGO46, LOGO49, LOGO52, LOGO55, LOGO58, LOGO61, LOGO64, LOGO67, LOGO70, LOGO73, LOGO76, LOGO79, LOGO82, LOGO85, LOGO88, LOGO91, LOGO94, LOGO97, LOGO100, LOGO103, LOGO106: SFE_LOGO_FLAME.1_INCH; SFE_LOGO_FLAME_.1
LOGO2, LOGO5, LOGO8, LOGO11, LOGO14, LOGO17, LOGO20, LOGO23, LOGO26, LOGO29, LOGO32, LOGO35, LOGO38, LOGO41, LOGO44, LOGO47, LOGO50, LOGO53, LOGO56, LOGO59, LOGO62, LOGO65, LOGO68, LOGO71, LOGO74, LOGO77, LOGO80, LOGO83, LOGO86, LOGO89, LOGO92, LOGO95, LOGO98, LOGO101, LOGO104, LOGO107: OSHW-LOGOS; OSHW-LOGO-S
LOGO3, LOGO6, LOGO9, LOGO12, LOGO15, LOGO18, LOGO21, LOGO24, LOGO27, LOGO30, LOGO33, LOGO36, LOGO39, LOGO42, LOGO45, LOGO48, LOGO51, LOGO54, LOGO57, LOGO60, LOGO63, LOGO66, LOGO69, LOGO72, LOGO75, LOGO78, LOGO81, LOGO84, LOGO87, LOGO90, LOGO93, LOGO96, LOGO99, LOGO102, LOGO105, LOGO108: SFE_LOGO_NAME_FLAME.1_INCH; SFE_LOGO_NAME_FLAME_.1
STANDOFF1, STANDOFF2, STANDOFF3, STANDOFF4, STANDOFF5, STANDOFF6, STANDOFF7, STANDOFF8, STANDOFF9, STANDOFF10, STANDOFF11, STANDOFF12, STANDOFF13, STANDOFF14, STANDOFF15, STANDOFF16, STANDOFF17, STANDOFF18, STANDOFF19, STANDOFF20, STANDOFF21, STANDOFF22, STANDOFF23, STANDOFF24, STANDOFF25, STANDOFF26, STANDOFF27, STANDOFF28, STANDOFF29, STANDOFF30, STANDOFF31, STANDOFF32, STANDOFF33, STANDOFF34, STANDOFF35, STANDOFF36: STAND-OFF
U1, U2, U3, U4, U5, U6, U7, U8, U9, U10, U11, U12, U13, U14, U15, U16, U17, U18, U19, U20, U21, U22, U23, U24, U25, U26, U27, U28, U29, U30, U31, U32, U33, U34, U35, U36: ADXL337; LFCSP_LQ-16

Connections:
3.3V: C4.1, JP1.2, U1.14, U1.15
3.3V1: C8.1, JP2.2, U2.14, U2.15
3.3V2: C12.1, JP3.2, U3.14, U3.15
3.3V3: C16.1, JP4.2, U4.14, U4.15
3.3V4: C20.1, JP5.2, U5.14, U5.15
3.3V5: C24.1, JP6.2, U6.14, U6.15
3.3V6: C28.1, JP7.2, U7.14, U7.15
3.3V7: C32.1, JP8.2, U8.14, U8.15
3.3V8: C36.1, JP9.2, U9.14, U9.15
3.3V9: C40.1, JP10.2, U10.14, U10.15
3.3V10: C44.1, JP11.2, U11.14, U11.15
3.3V11: C48.1, JP12.2, U12.14, U12.15
3.3V12: C52.1, JP13.2, U13.14, U13.15
3.3V13: C56.1, JP14.2, U14.14, U14.15
3.3V14: C60.1, JP15.2, U15.14, U15.15
3.3V15: C64.1, JP16.2, U16.14, U16.15
3.3V16: C68.1, JP17.2, U17.14, U17.15
3.3V17: C72.1, JP18.2, U18.14, U18.15
3.3V18: C76.1, JP19.2, U19.14, U19.15
3.3V19: C80.1, JP20.2, U20.14, U20.15
3.3V20: C84.1, JP21.2, U21.14, U21.15
3.3V21: C88.1, JP22.2, U22.14, U22.15
3.3V22: C92.1, JP23.2, U23.14, U23.15
3.3V23: C96.1, JP24.2, U24.14, U24.15
3.3V24: C100.1, JP25.2, U25.14, U25.15
3.3V25: C104.1, JP26.2, U26.14, U26.15
3.3V26: C108.1, JP27.2, U27.14, U27.15
3.3V27: C112.1, JP28.2, U28.14, U28.15
3.3V28: C116.1, JP29.2, U29.14, U29.15
3.3V29: C120.1, JP30.2, U30.14, U30.15
3.3V30: C124.1, JP31.2, U31.14, U31.15
3.3V31: C128.1, JP32.2, U32.14, U32.15
3.3V32: C132.1, JP33.2, U33.14, U33.15
3.3V33: C136.1, JP34.2, U34.14, U34.15
3.3V34: C140.1, JP35.2, U35.14, U35.15
3.3V35: C144.1, JP36.2, U36.14, U36.15
GND: C1.2, C2.2, C3.2, C4.2, JP1.1, U1.6, U1.7
GND1: C5.2, C6.2, C7.2, C8.2, JP2.1, U2.6, U2.7
GND2: C9.2, C10.2, C11.2, C12.2, JP3.1, U3.6, U3.7
GND3: C13.2, C14.2, C15.2, C16.2, JP4.1, U4.6, U4.7
GND4: C17.2, C18.2, C19.2, C20.2, JP5.1, U5.6, U5.7
GND5: C21.2, C22.2, C23.2, C24.2, JP6.1, U6.6, U6.7
GND6: C25.2, C26.2, C27.2, C28.2, JP7.1, U7.6, U7.7
GND7: C29.2, C30.2, C31.2, C32.2, JP8.1, U8.6, U8.7
GND8: C33.2, C34.2, C35.2, C36.2, JP9.1, U9.6, U9.7
GND9: C37.2, C38.2, C39.2, C40.2, JP10.1, U10.6, U10.7
GND10: C41.2, C42.2, C43.2, C44.2, JP11.1, U11.6, U11.7
GND11: C45.2, C46.2, C47.2, C48.2, JP12.1, U12.6, U12.7
GND12: C49.2, C50.2, C51.2, C52.2, JP13.1, U13.6, U13.7
GND13: C53.2, C54.2, C55.2, C56.2, JP14.1, U14.6, U14.7
GND14: C57.2, C58.2, C59.2, C60.2, JP15.1, U15.6, U15.7
GND15: C61.2, C62.2, C63.2, C64.2, JP16.1, U16.6, U16.7
GND16: C65.2, C66.2, C67.2, C68.2, JP17.1, U17.6, U17.7
GND17: C69.2, C70.2, C71.2, C72.2, JP18.1, U18.6, U18.7
GND18: C73.2, C74.2, C75.2, C76.2, JP19.1, U19.6, U19.7
GND19: C77.2, C78.2, C79.2, C80.2, JP20.1, U20.6, U20.7
GND20: C81.2, C82.2, C83.2, C84.2, JP21.1, U21.6, U21.7
GND21: C85.2, C86.2, C87.2, C88.2, JP22.1, U22.6, U22.7
GND22: C89.2, C90.2, C91.2, C92.2, JP23.1, U23.6, U23.7
GND23: C93.2, C94.2, C95.2, C96.2, JP24.1, U24.6, U24.7
GND24: C97.2, C98.2, C99.2, C100.2, JP25.1, U25.6, U25.7
GND25: C101.2, C102.2, C103.2, C104.2, JP26.1, U26.6, U26.7
GND26: C105.2, C106.2, C107.2, C108.2, JP27.1, U27.6, U27.7
GND27: C109.2, C110.2, C111.2, C112.2, JP28.1, U28.6, U28.7
GND28: C113.2, C114.2, C115.2, C116.2, JP29.1, U29.6, U29.7
GND29: C117.2, C118.2, C119.2, C120.2, JP30.1, U30.6, U30.7
GND30: C121.2, C122.2, C123.2, C124.2, JP31.1, U31.6, U31.7
GND31: C125.2, C126.2, C127.2, C128.2, JP32.1, U32.6, U32.7
GND32: C129.2, C130.2, C131.2, C132.2, JP33.1, U33.6, U33.7
GND33: C133.2, C134.2, C135.2, C136.2, JP34.1, U34.6, U34.7
GND34: C137.2, C138.2, C139.2, C140.2, JP35.1, U35.6, U35.7
GND35: C141.2, C142.2, C143.2, C144.2, JP36.1, U36.6, U36.7
ST: JP1.6, U1.2
ST1: JP2.6, U2.2
ST2: JP3.6, U3.2
ST3: JP4.6, U4.2
ST4: JP5.6, U5.2
ST5: JP6.6, U6.2
ST6: JP7.6, U7.2
ST7: JP8.6, U8.2
ST8: JP9.6, U9.2
ST9: JP10.6, U10.2
ST10: JP11.6, U11.2
ST11: JP12.6, U12.2
ST12: JP13.6, U13.2
ST13: JP14.6, U14.2
ST14: JP15.6, U15.2
ST15: JP16.6, U16.2
ST16: JP17.6, U17.2
ST17: JP18.6, U18.2
ST18: JP19.6, U19.2
ST19: JP20.6, U20.2
ST20: JP21.6, U21.2
ST21: JP22.6, U22.2
ST22: JP23.6, U23.2
ST23: JP24.6, U24.2
ST24: JP25.6, U25.2
ST25: JP26.6, U26.2
ST26: JP27.6, U27.2
ST27: JP28.6, U28.2
ST28: JP29.6, U29.2
ST29: JP30.6, U30.2
ST30: JP31.6, U31.2
ST31: JP32.6, U32.2
ST32: JP33.6, U33.2
ST33: JP34.6, U34.2
ST34: JP35.6, U35.2
ST35: JP36.6, U36.2
X: C1.1, JP1.3, U1.5
X1: C5.1, JP2.3, U2.5
X2: C9.1, JP3.3, U3.5
X3: C13.1, JP4.3, U4.5
X4: C17.1, JP5.3, U5.5
X5: C21.1, JP6.3, U6.5
X6: C25.1, JP7.3, U7.5
X7: C29.1, JP8.3, U8.5
X8: C33.1, JP9.3, U9.5
X9: C37.1, JP10.3, U10.5
X10: C41.1, JP11.3, U11.5
X11: C45.1, JP12.3, U12.5
X12: C49.1, JP13.3, U13.5
X13: C53.1, JP14.3, U14.5
X14: C57.1, JP15.3, U15.5
X15: C61.1, JP16.3, U16.5
X16: C65.1, JP17.3, U17.5
X17: C69.1, JP18.3, U18.5
X18: C73.1, JP19.3, U19.5
X19: C77.1, JP20.3, U20.5
X20: C81.1, JP21.3, U21.5
X21: C85.1, JP22.3, U22.5
X22: C89.1, JP23.3, U23.5
X23: C93.1, JP24.3, U24.5
X24: C97.1, JP25.3, U25.5
X25: C101.1, JP26.3, U26.5
X26: C105.1, JP27.3, U27.5
X27: C109.1, JP28.3, U28.5
X28: C113.1, JP29.3, U29.5
X29: C117.1, JP30.3, U30.5
X30: C121.1, JP31.3, U31.5
X31: C125.1, JP32.3, U32.5
X32: C129.1, JP33.3, U33.5
X33: C133.1, JP34.3, U34.5
X34: C137.1, JP35.3, U35.5
X35: C141.1, JP36.3, U36.5
Y: C2.1, JP1.4, U1.4
Y1: C6.1, JP2.4, U2.4
Y2: C10.1, JP3.4, U3.4
Y3: C14.1, JP4.4, U4.4
Y4: C18.1, JP5.4, U5.4
Y5: C22.1, JP6.4, U6.4
Y6: C26.1, JP7.4, U7.4
Y7: C30.1, JP8.4, U8.4
Y8: C34.1, JP9.4, U9.4
Y9: C38.1, JP10.4, U10.4
Y10: C42.1, JP11.4, U11.4
Y11: C46.1, JP12.4, U12.4
Y12: C50.1, JP13.4, U13.4
Y13: C54.1, JP14.4, U14.4
Y14: C58.1, JP15.4, U15.4
Y15: C62.1, JP16.4, U16.4
Y16: C66.1, JP17.4, U17.4
Y17: C70.1, JP18.4, U18.4
Y18: C74.1, JP19.4, U19.4
Y19: C78.1, JP20.4, U20.4
Y20: C82.1, JP21.4, U21.4
Y21: C86.1, JP22.4, U22.4
Y22: C90.1, JP23.4, U23.4
Y23: C94.1, JP24.4, U24.4
Y24: C98.1, JP25.4, U25.4
Y25: C102.1, JP26.4, U26.4
Y26: C106.1, JP27.4, U27.4
Y27: C110.1, JP28.4, U28.4
Y28: C114.1, JP29.4, U29.4
Y29: C118.1, JP30.4, U30.4
Y30: C122.1, JP31.4, U31.4
Y31: C126.1, JP32.4, U32.4
Y32: C130.1, JP33.4, U33.4
Y33: C134.1, JP34.4, U34.4
Y34: C138.1, JP35.4, U35.4
Y35: C142.1, JP36.4, U36.4
Z: C3.1, JP1.5, U1.16
Z1: C7.1, JP2.5, U2.16
Z2: C11.1, JP3.5, U3.16
Z3: C15.1, JP4.5, U4.16
Z4: C19.1, JP5.5, U5.16
Z5: C23.1, JP6.5, U6.16
Z6: C27.1, JP7.5, U7.16
Z7: C31.1, JP8.5, U8.16
Z8: C35.1, JP9.5, U9.16
Z9: C39.1, JP10.5, U10.16
Z10: C43.1, JP11.5, U11.16
Z11: C47.1, JP12.5, U12.16
Z12: C51.1, JP13.5, U13.16
Z13: C55.1, JP14.5, U14.16
Z14: C59.1, JP15.5, U15.16
Z15: C63.1, JP16.5, U16.16
Z16: C67.1, JP17.5, U17.16
Z17: C71.1, JP18.5, U18.16
Z18: C75.1, JP19.5, U19.16
Z19: C79.1, JP20.5, U20.16
Z20: C83.1, JP21.5, U21.16
Z21: C87.1, JP22.5, U22.16
Z22: C91.1, JP23.5, U23.16
Z23: C95.1, JP24.5, U24.16
Z24: C99.1, JP25.5, U25.16
Z25: C103.1, JP26.5, U26.16
Z26: C107.1, JP27.5, U27.16
Z27: C111.1, JP28.5, U28.16
Z28: C115.1, JP29.5, U29.16
Z29: C119.1, JP30.5, U30.16
Z30: C123.1, JP31.5, U31.16
Z31: C127.1, JP32.5, U32.16
Z32: C131.1, JP33.5, U33.16
Z33: C135.1, JP34.5, U34.16
Z34: C139.1, JP35.5, U35.16
Z35: C143.1, JP36.5, U36.16
