asamland/NU-Smarticle/(commit log)

2019-03-09 adafruit feather 328p
    [Adafruit Feather 328P.brd, Adafruit Feather 328P.sch]
2019-03-09 Arduino Pro Mini
    [Arduino-Pro-Mini.brd, Arduino-Pro-Mini.sch]
2019-03-09 FTDI Basic
    [FTDI Basic-v22-3.3V.brd, FTDI Basic-v22-3.3V.sch]
2019-03-09 schematics and boards
    [NU-Smarticles.sch, NU-Smarticles_old.brd, NU-Smarticles_old.sch]
2019-07-25 include v2 Smarticles
    [Adafruit Feather 328P.brd, NU-Smarticle v2.brd, NU-Smarticle v2.csv, NU-Smarticle v2.sch, NU-Smarticles.brd, NU-Smarticles.sch, NU-Smarticles_old.brd, NU-Smarticles_old.sch]
2019-07-31 updated case3
    [Case_3.SLDPRT]
2019-08-06 xbee config info
    [xbee_config_info.xlsx]
2019-09-27 renamed eagle project
    [feather-v1.brd, feather-v1.sch, topboard-v1.brd, topboard-v1.sch]
2019-09-27 eagle v2 work
    [NU-Smarticle v2.csv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]
2019-09-27 rename folders
    [xbee_config_info.xlsx]
2019-09-27 renamed folder
    [ADMP401-Breakout-v13.brd, ADMP401-Breakout-v13.sch, Adafruit Feather 328P.brd, Adafruit Feather 328P.sch]
2019-10-22 added holes for securing feather board
    [Case_3.SLDPRT, Case_3.STL, Feather.SLDPRT]
2019-10-22 eagle work and files added
    [ADXL337 Breakout-Panel-v10.brd, ADXL337 Breakout.brd, ADXL337 Breakout.sch, Inventory-v2.0.xlsx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]
2019-10-24 cleaned up solidworks directory
    [Battery - Assembly.SLDASM, Battery - Body.SLDPRT, Battery - Connector.SLDPRT, Battery Back.SLDPRT, Case.SLDPRT, Case_2.SLDPRT, Case_3.STL, NU-ring.STL]
2019-10-24 spill ring added
    [Spill_Ring.SLDPRT, Spill_Ring.STL]
2019-10-24 smarticle case updates
    1) make space bigger for feather board
    2) make holes bigger for arms
    3)prevent beads from seeping in by adding guards
    [Case_3.SLDPRT, Case_3.STL]
2019-10-24 spiked ring
    [Spill_Ring.SLDPRT, spiked_ring.STL]
2019-11-01 arm CAD
    [Case_3.SLDPRT, Case_3.STL, Full_Arm.SLDPRT, Half_Arm.SLDPRT, Half_Arm.STL, Half_Arm_test.STL]
2019-11-01 more arms
    [Half_Arm.SLDPRT, Half_Arm.STL, Half_Arm_test.STL]
2019-11-01 more arm
    [Half_Arm.SLDPRT, Half_Arm.STL, Half_Arm_test.STL]
2019-11-04 arm is done!
    [Half_Arm.SLDPRT, Half_Arm_test.STL]
2019-11-05 arm and inventory
    [Half_Arm.STL, Inventory-v2.0.xlsx]
2019-11-21 case changes
    1) changed case to make it easier to put arms in
    2) made changes to make it easier to put in feather board
    [Case_3.SLDPRT, Case_3.STL]
2019-11-24 hardware work
    [Inventory-v2.0.xlsx, Smarticle_Status.xlsx]
2019-12-10 small spill ring
    [Spill_Ring_small_no_crown.SLDPRT, Spill_Ring_small_no_crown.STL]
2020-01-08 cad work for tommy
    [Flag_ring_w_lip.SLDPRT, Spill_Ring_small_no_crown.SLDPRT, gate.SLDPRT, slide.SLDPRT]
2020-01-10 inventory update and april tags
    [Inventory-v2.0.xlsx]
2020-01-16 herding ring
    [230mm_ring.SLDPRT, 230mm_ring.STL]
2020-01-16 220mm ring
    [220mm_ring.SLDPRT, 220mm_ring.STL]
2020-01-19 230mm ring in thirds
    [230mm_ring_thirds.SLDPRT, 230mm_ring_thirds.STL]
2020-01-20 192mm ring
    [192mm_ring.SLDPRT, 192mm_ring.STL]
2020-01-23 new rings
    [192mm_ring.SLDPRT, 192mm_ring.STL, 211mm_ring_thirds.SLDPRT, 211mm_ring_thirds.STL, 230mm_ring_thirds.SLDPRT, 230mm_ring_thirds.STL]
2020-01-23 new ring
    [192mm_ring.SLDPRT, 192mm_ring.STL, 211mm_ring_thirds.SLDPRT, 211mm_ring_thirds.STL]
2020-01-24 updated inventory
    [Inventory-v2.0.xlsx]
2020-01-24 200mm ring
    [200mm_ring_thirds.SLDPRT, 200mm_ring_thirds.STL]
2020-02-05 soldiworks changes
    [Assem1.SLDASM, Battery - Assembly.SLDASM, Battery - Body.SLDPRT, Battery - Connector.SLDPRT, Case_3.SLDPRT, Feather.SLDPRT, Half_Arm.SLDPRT, Servo - Assembly.SLDASM]
2020-02-06 new urdf
    [Case_3.SLDPRT, Half_Arm.SLDPRT, Smarticle_URDF.csv, base_link.STL, left_arm.STL, right_arm.STL, simulation_arm.SLDPRT, simulation_assembly.SLDASM]
2020-02-06 ring stl
    [Part1.STL, Part1.urdf]
2020-02-07 obj file
    [Part1.SLDPRT, ring.obj]
2020-02-07 new simulation cad
    [Half_Arm.SLDPRT, simulation_arm.SLDPRT, simulation_assembly.SLDASM, simulation_body.SLDPRT]
2020-02-17 organize solidworks folder
    [Arm.SLDPRT, Assem1.SLDASM, B2B-PH-K-S.STEP, Battery - Assembly.SLDASM, Battery - Body.SLDPRT, Battery - Connector.SLDPRT, Body.SLDPRT, Case_3.STL]
2020-03-05 update inventory, eagle
    [Inventory-v2.0.xlsx, Sawyer_Adapter_Tool_Plate_customer_use_(Rethink_Grippers).sldprt, feather-v2.0.brd, feather-v2.0.sch]
2020-03-06 hope this is ok
    [200mm_ring_solid.SLDPRT, Arm.SLDPRT, base_link.STL, left_arm.STL, right_arm.STL, simulation_arm.SLDPRT, simulation_assembly.SLDASM, simulation_urdf.csv]
2020-03-08 cad for light holder
    [Sawyer_Adapter_Tool_Plate_customer_use_(Rethink_Grippers).sldprt, Sawyer_lightHolder.SLDPRT, Sawyer_lightHolder.STL, clamping_part.SLDPRT, clamping_part.STL]
2020-03-09 more cad
    [Sawyer_Adapter_Tool_Plate_customer_use_(Rethink_Grippers).sldprt, Sawyer_lightHolder.SLDPRT, Sawyer_lightHolder.STL]
2020-03-09 more cad
    revisions to light holding piece after printing prototypes
    [Sawyer_lightHolder.SLDPRT, Sawyer_lightHolder.STL, clamping_part.SLDPRT, clamping_part.STL]
